emwhbr/caramon/README.md

caramon
=======

Climate monitor for a caravan.

Based on Raspberry Pi2 with sensors for internal temperature,
internal humidity and external temperature. Data logging is done
via cloud and to local disk.
