emwhbr/caramon/doc/temperature_control_2016/temperature_pid_control_2016.odp

## Temperature PID Control

A practical approach using Ziegler-Nichols

Caramon Pi

Håkan Brolin, 2016-01-23

## Closed Loop System

Improved controller, by basing the derivative term on the process value only

PID algorithm

Discrete form

## Ziegler-Nichols


Closed-loop tuning method

Ulitmate gain, Ku=360

Ultimate period, Pu=35 minutes = 2100 sec

Sample time, Ts = 10 minutes = 600 sec

| Kp | Ti | Td
P | Ku / 2 | - | -
PI | Ku / 2.2 | Pu / 1.2 | -
PID | Ku / 1.7 | Pu / 2 | Pu / 8

## Controller Parameters

Ku | 360
Pu [s] | 2100
Ts [s] | 600

| Kp | Ti [s] | Td [s]
P | 180.00 | - | -
PI | 163.64 | 1750 | -
PID | 211.76 | 1050 | 262.50

Z-N

Ki = (Kp x Ts) / Ti

Kd = (Kp x Td) / Ts

| Kp | Ki | Kd | Comment
PID-5 | 163.64 | 56.10 | - | Z-N, PI
PID-6 | 211.76 | 121.01 | 92.65 | Z-N, PID
PID-7 | 163.64 | 42.10 | - | PID-5, Ki decreased 25%
PID-8 | 163.64 | 28.05 | - | PID-5, Ki decreased 50%

## Comparison, Step-up

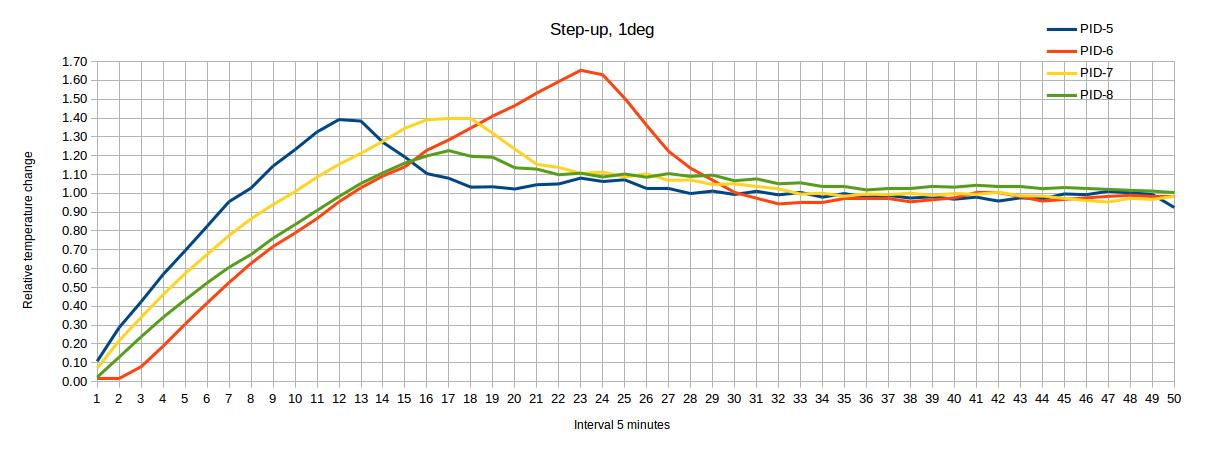
[picture p2: figure]

## Comparison, Step-down

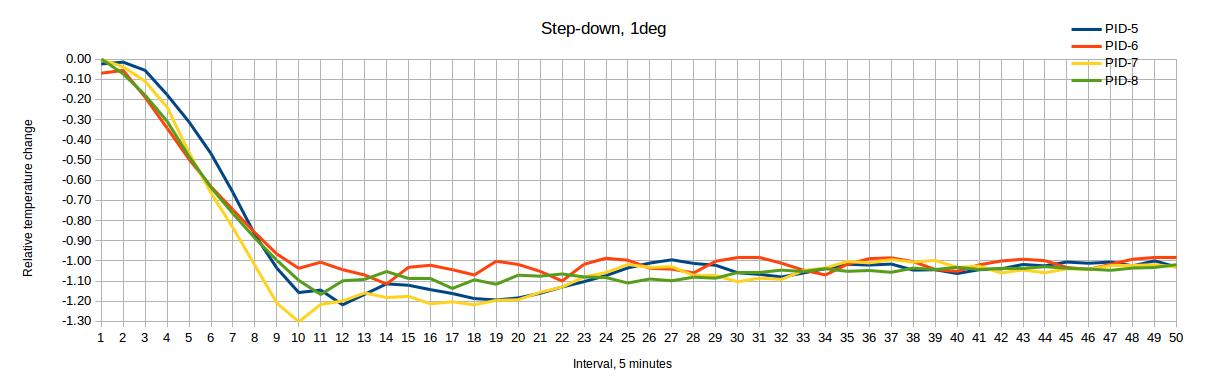
[picture p3: figure]

## Slide 7

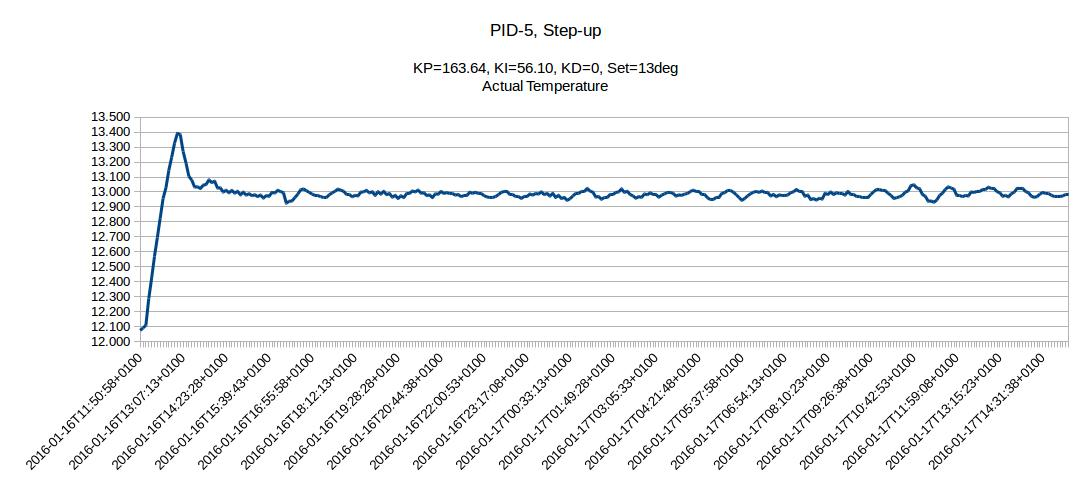
[picture p4: figure]

## Slide 8

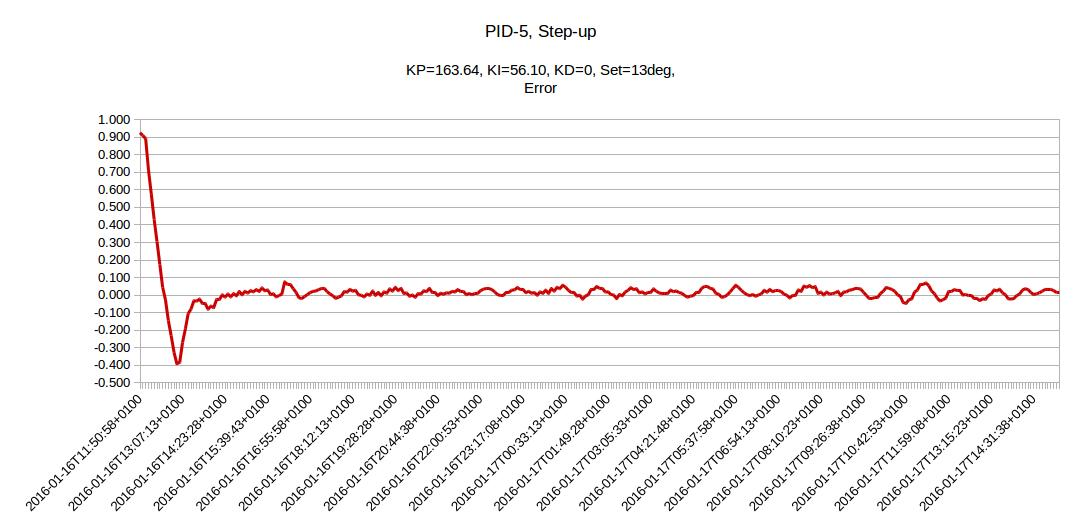
[picture p5: figure]

## Slide 9

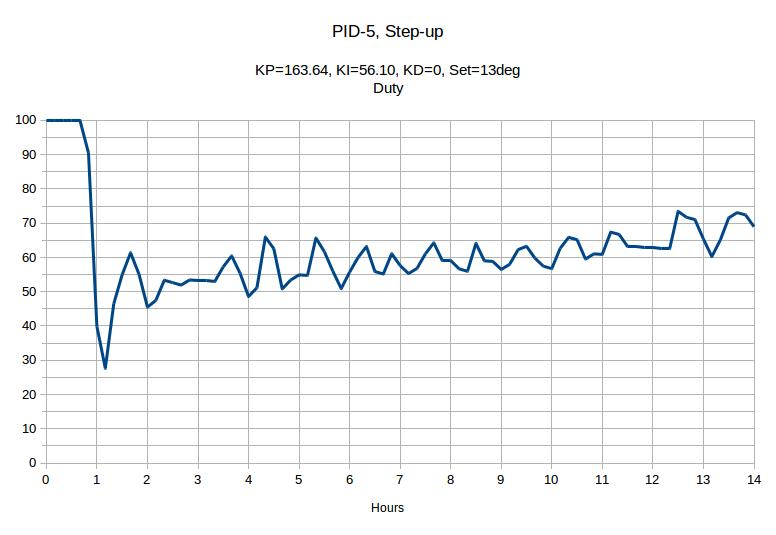
[picture p6: figure]

## Slide 10

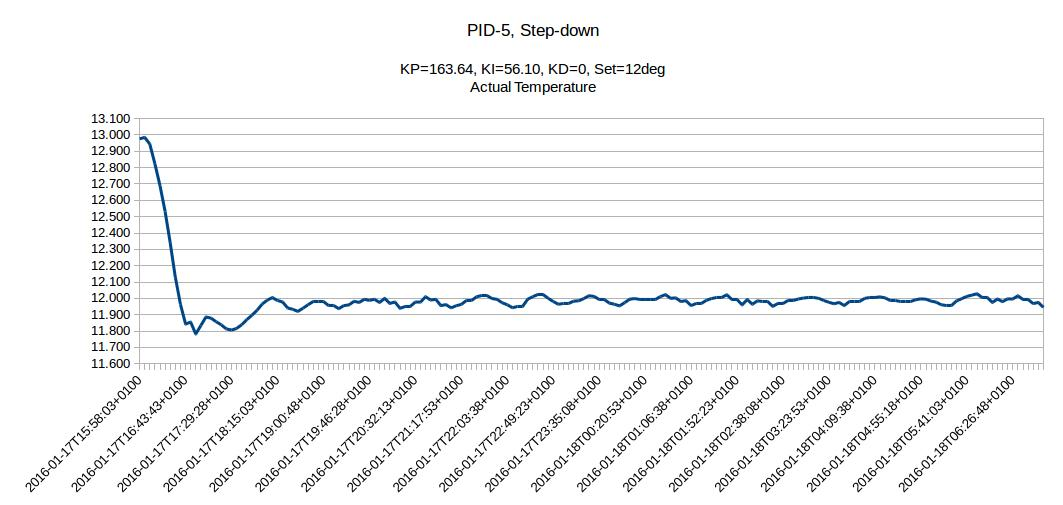
[picture p7: figure]

## Slide 11

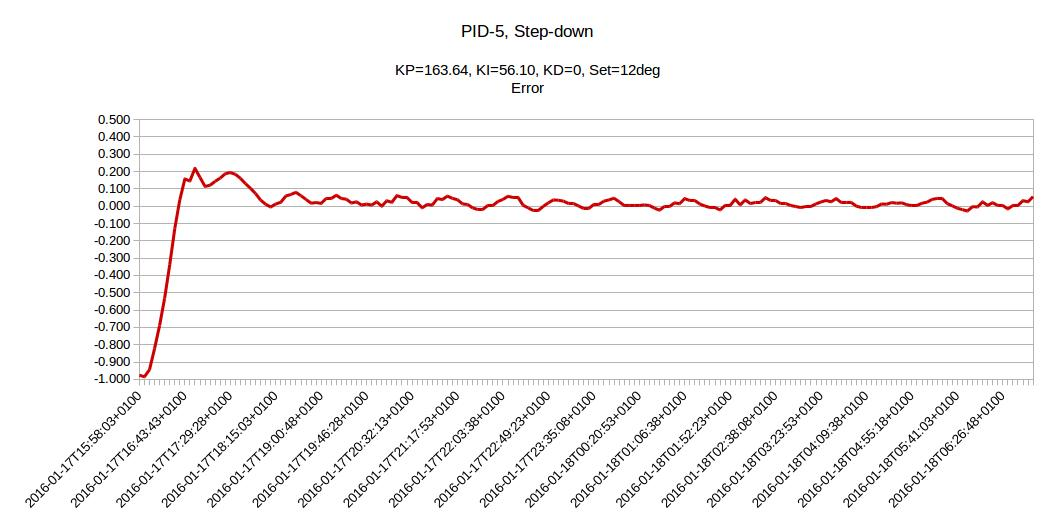
[picture p8: figure]

## Slide 12

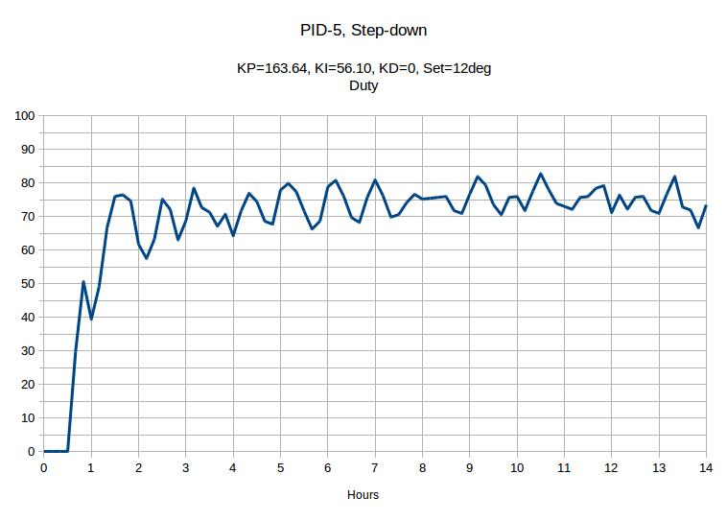
[picture p9: figure]

## Slide 13

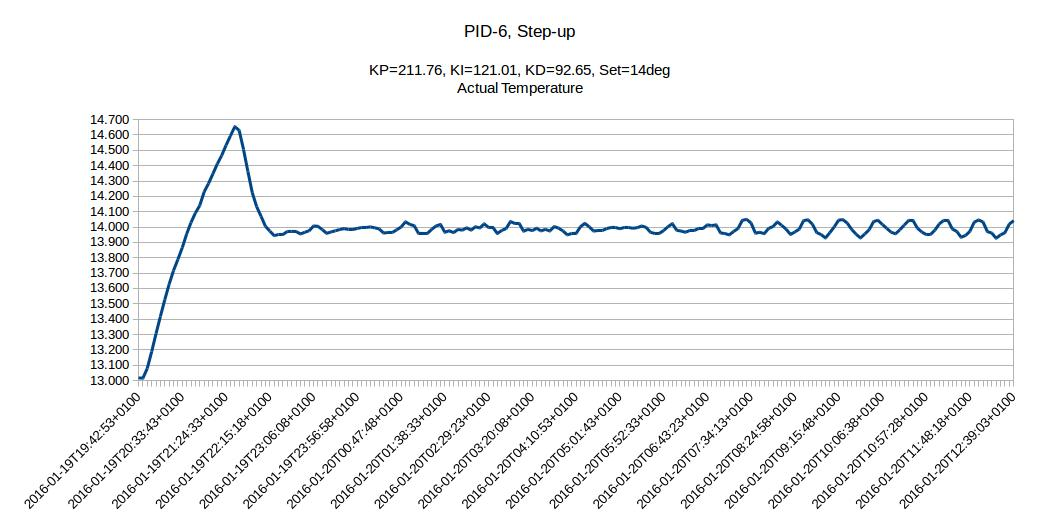
[picture p10: figure]

## Slide 14

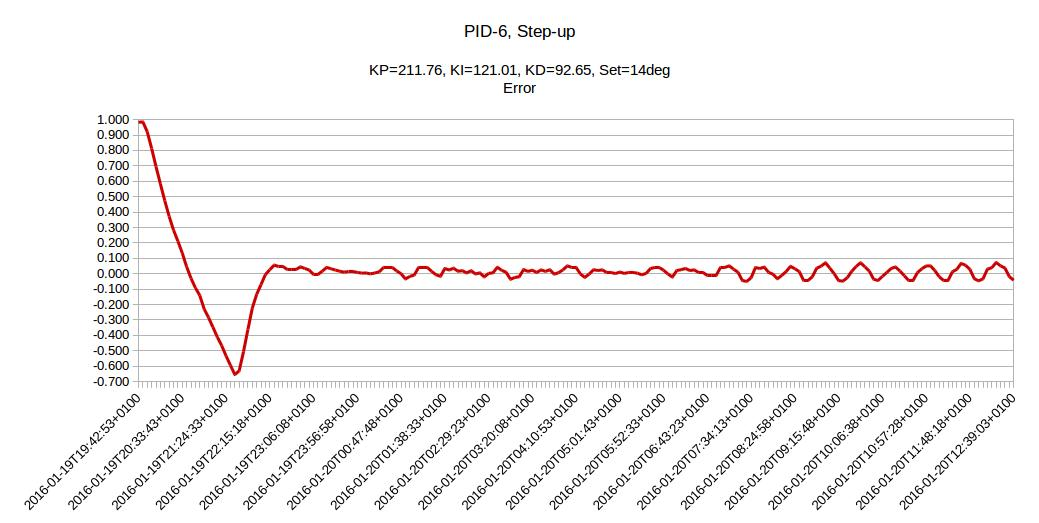
[picture p11: figure]

## Slide 15

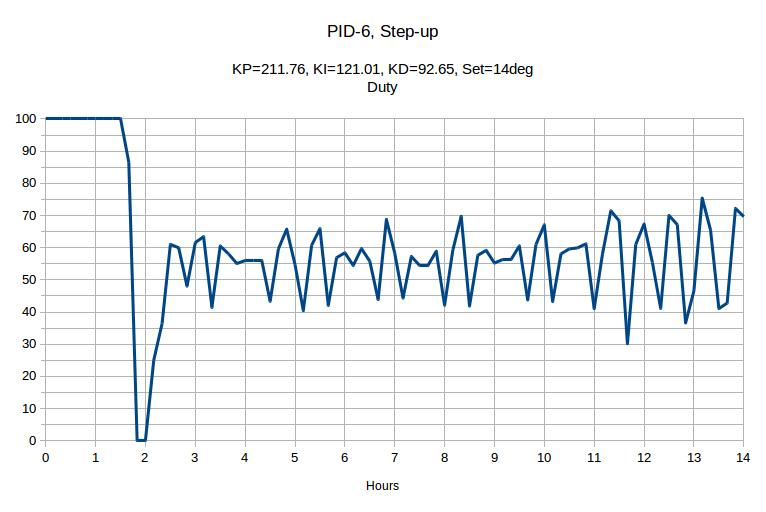
[picture p12: figure]

## Slide 16

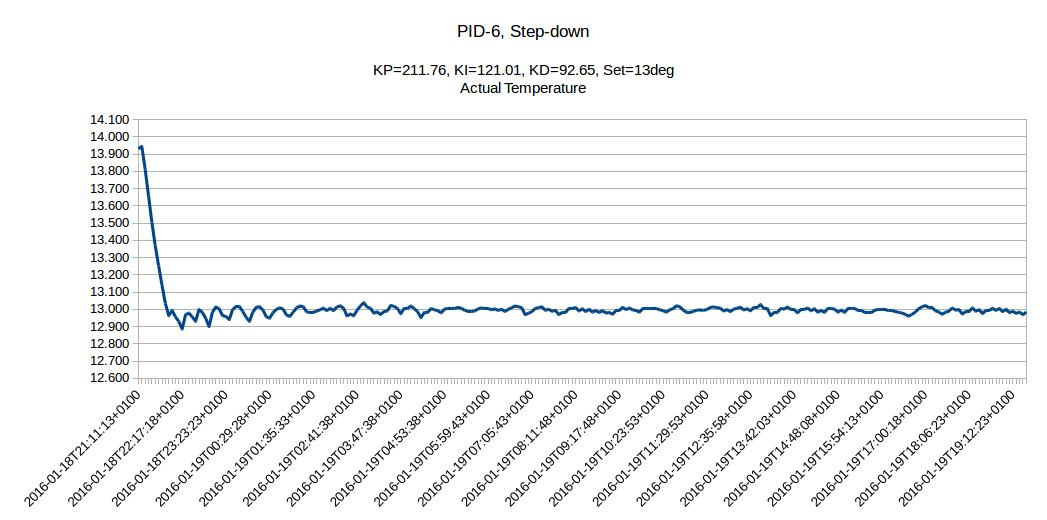
[picture p13: figure]

## Slide 17

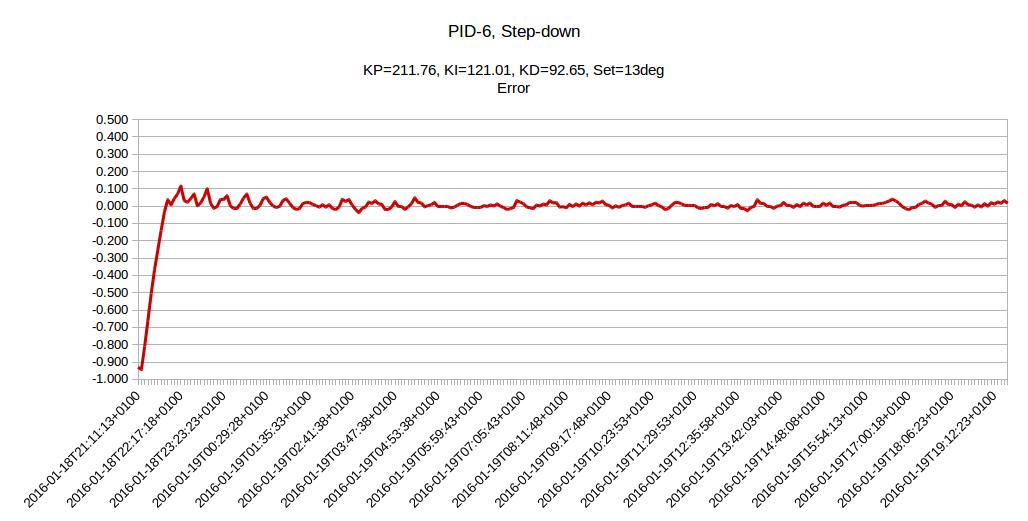
[picture p14: figure]

## Slide 18

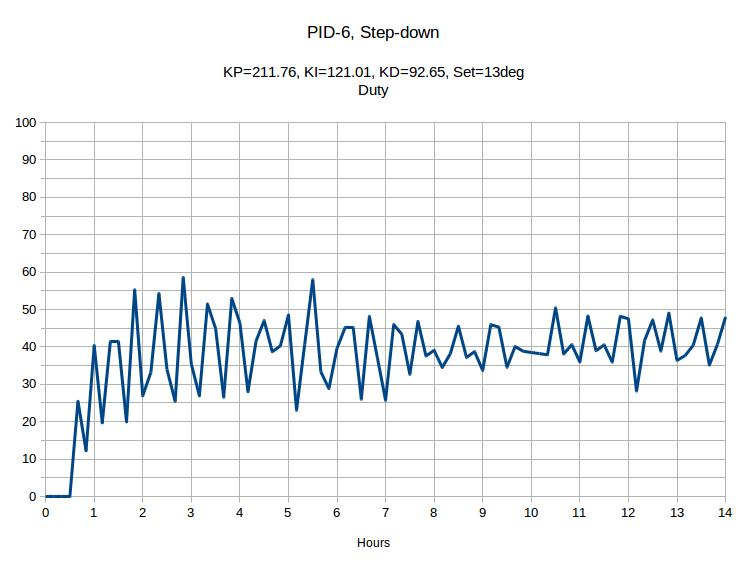
[picture p15: figure]

## Slide 19

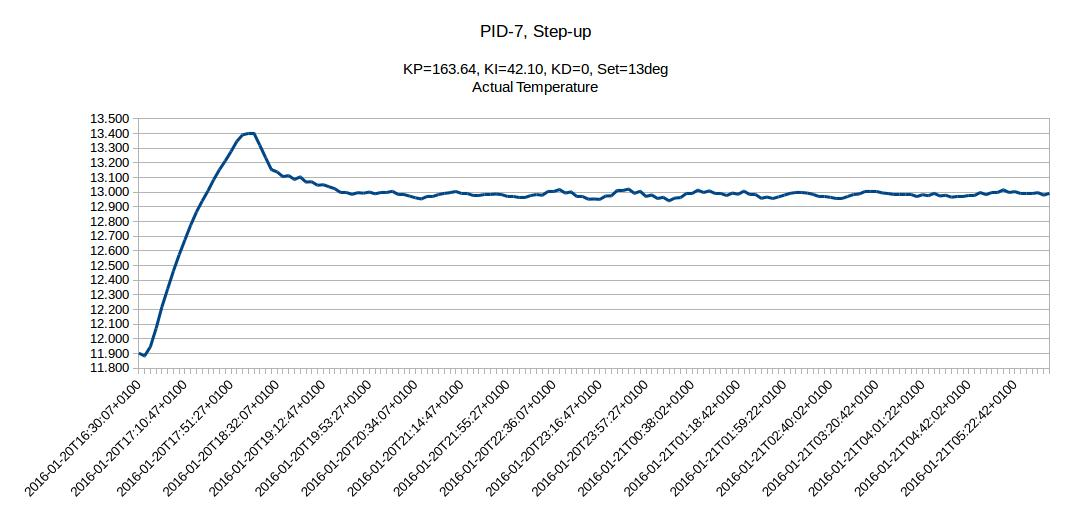
[picture p16: figure]

## Slide 20

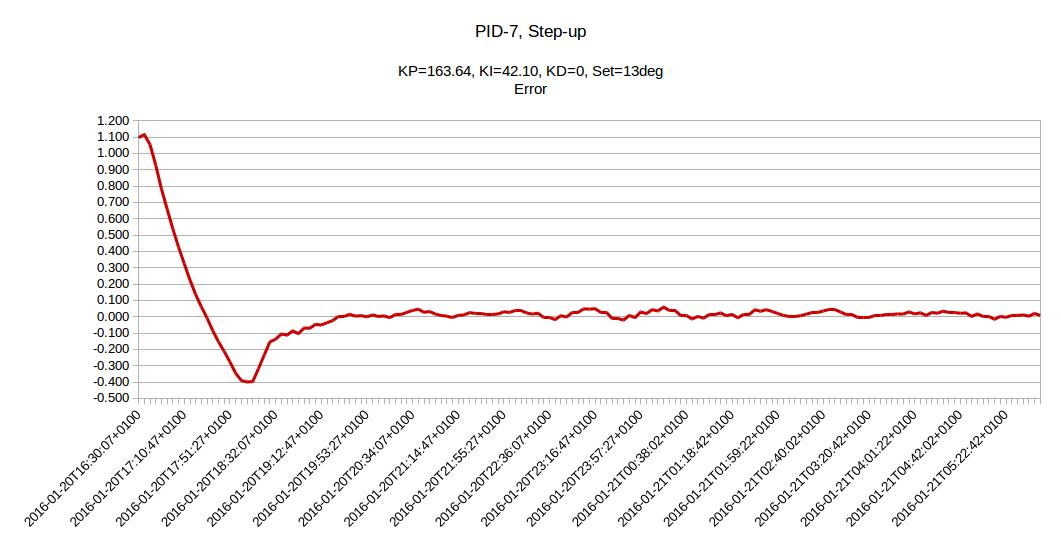
[picture p17: figure]

## Slide 21

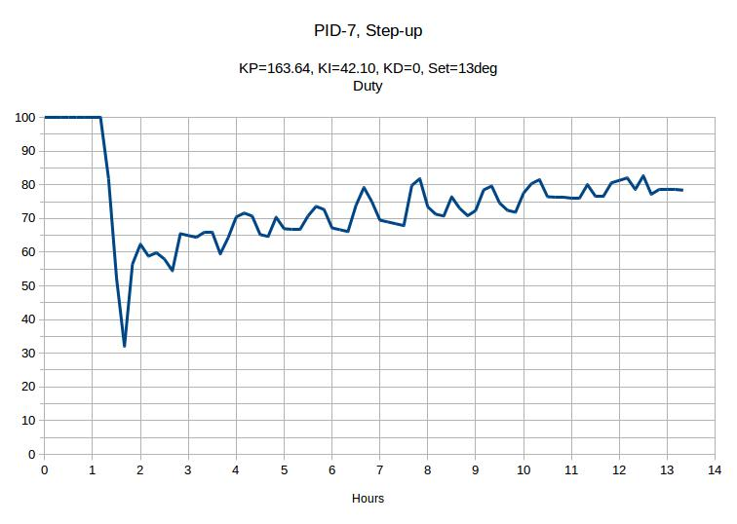
[picture p18: figure]

## Slide 22

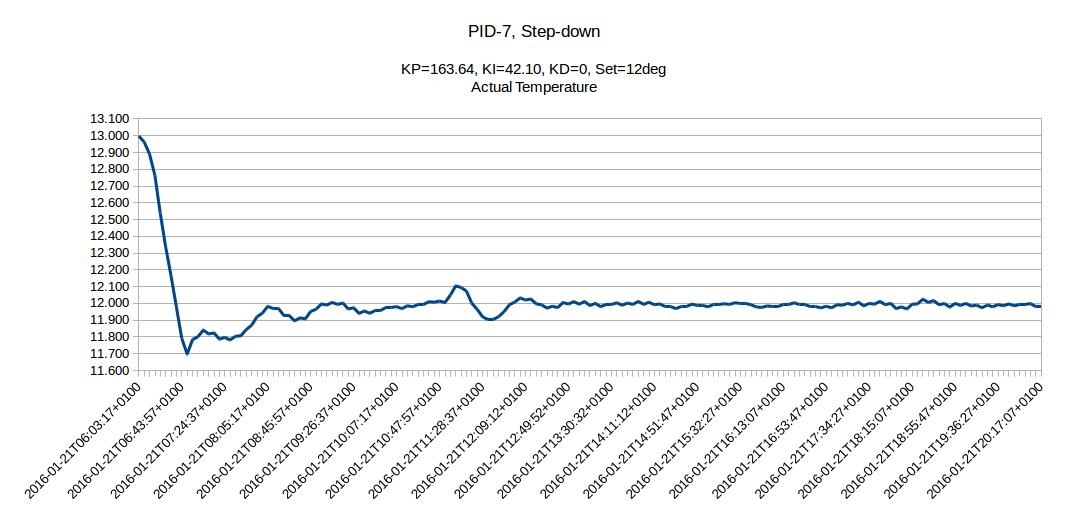
[picture p19: figure]

## Slide 23

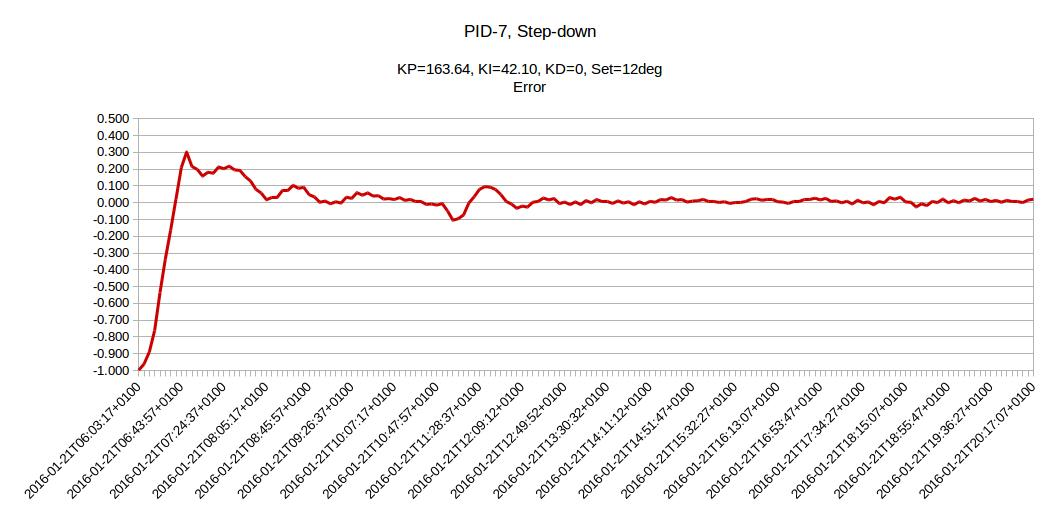
[picture p20: figure]

## Slide 24

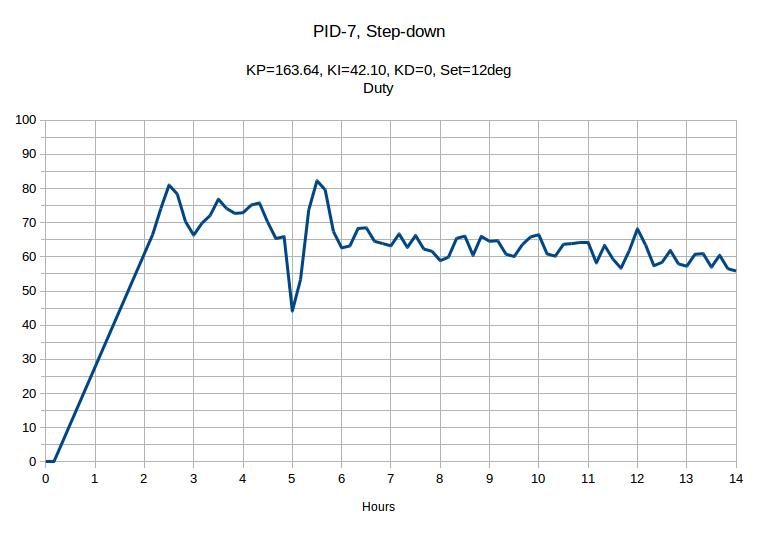
[picture p21: figure]

## Slide 25

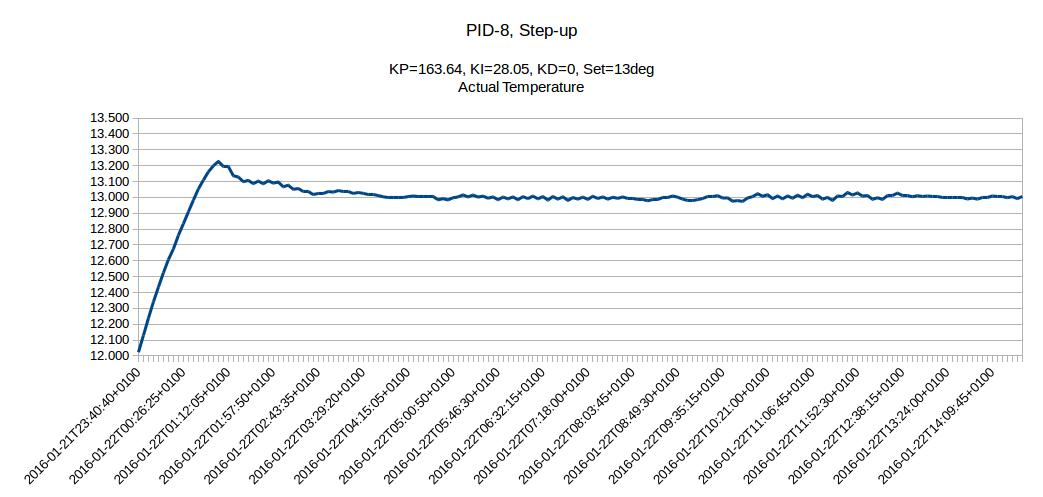
[picture p22: figure]

## Slide 26

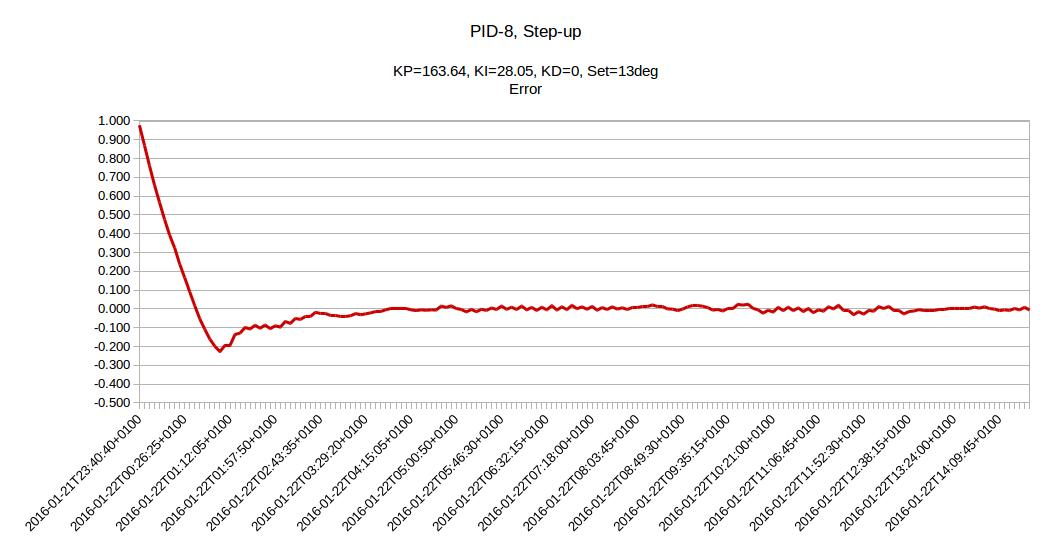
[picture p23: figure]

## Slide 27

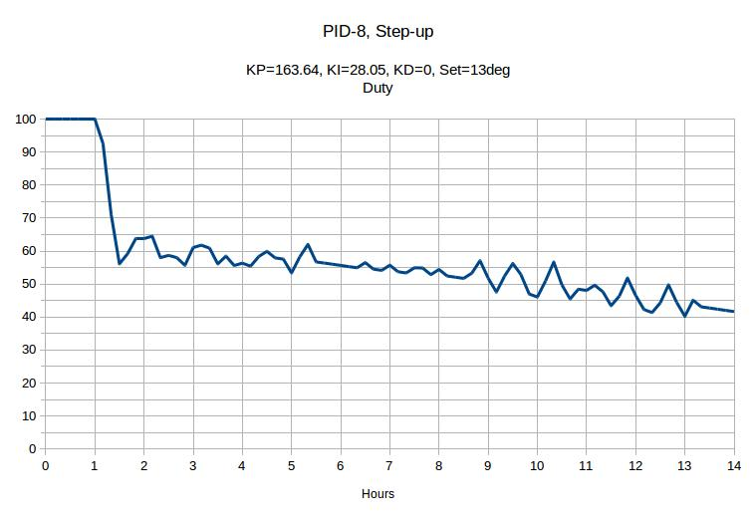
[picture p24: figure]

## Slide 28

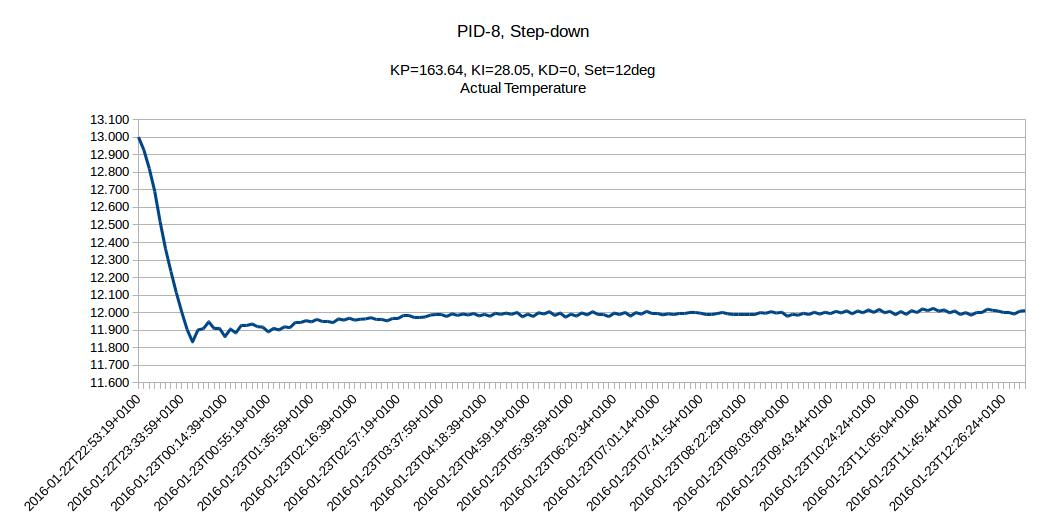
[picture p25: figure]

## Slide 29

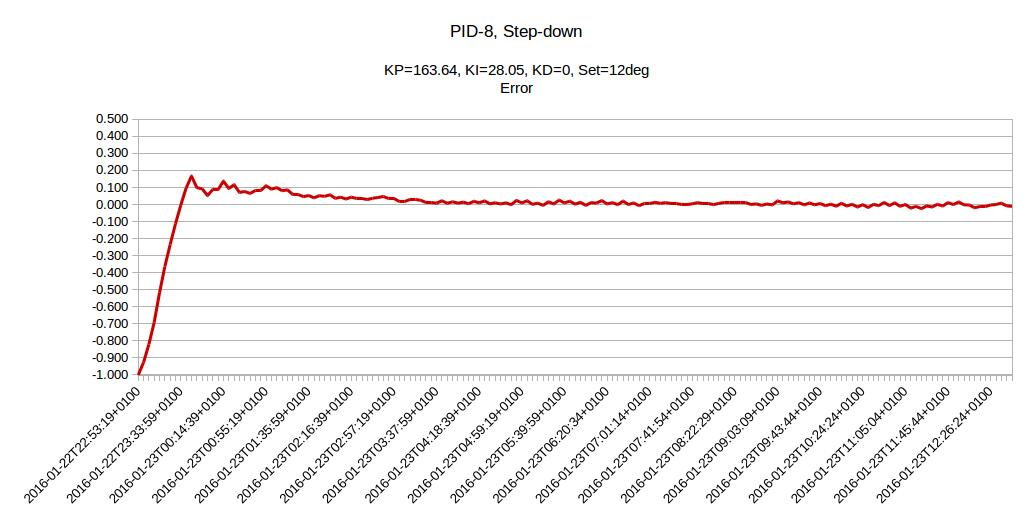
[picture p26: figure]

## Slide 30

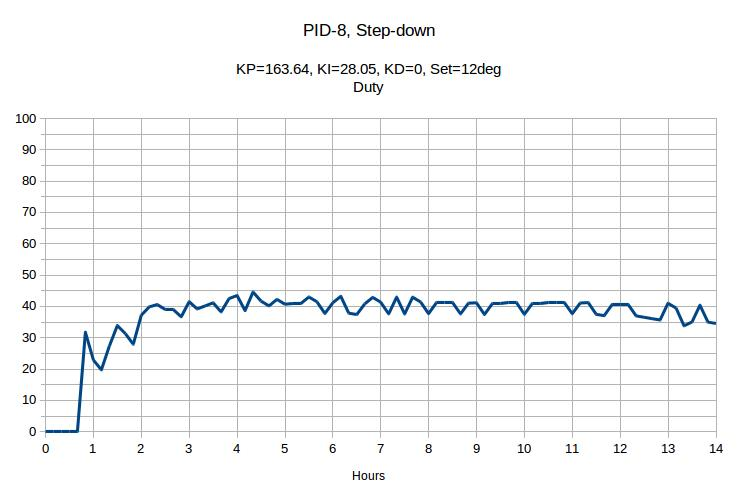
[picture p27: figure]
