emwhbr/caramon/doc/caramon_description.pdf

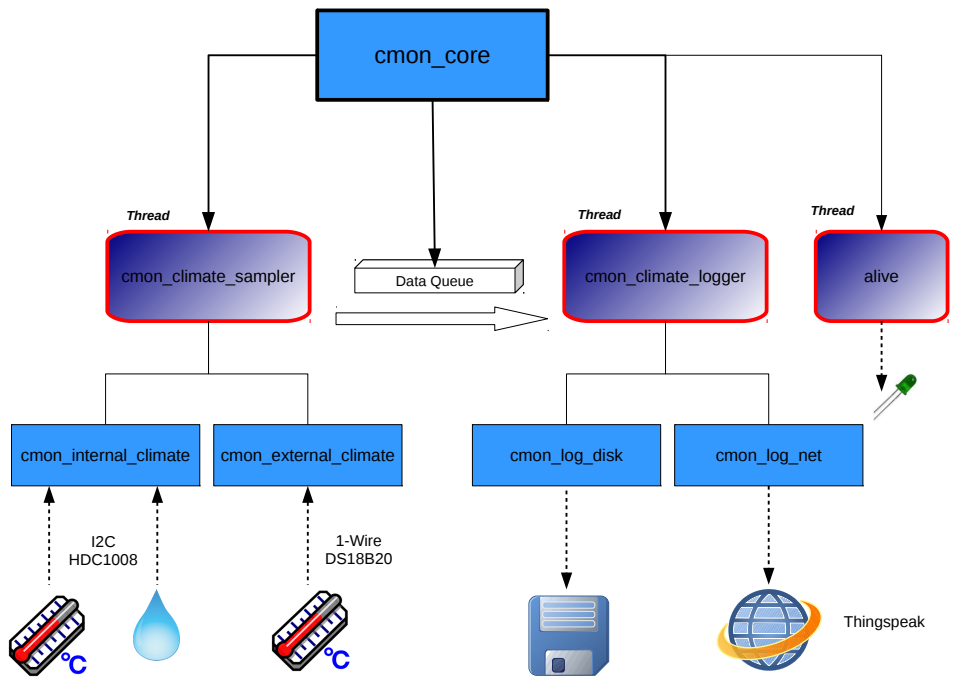
[picture p28: page 1]
cmon_core; cmon_climate_logger; Thread; cmon_climate_sampler; cmon_internal_climate; cmon_external_climate; cmon_log_disk; cmon_log_net; Data Queue; I2C HDC1008; 1-Wire DS18B20; Thingspeak; alive

glost_core

- m_mode
- m_local_ip
- m_verbose
- virtual initialize()
- virtual finalize()
- virtual check_ok()

cmon_log

- m_name
- m_verbose
- virtual initialize() = 0
- virtual finalize() = 0
- virtual log_climate_data = 0
- get_date_time_str()

cmon_log_disk

- m_climate_data_file
- initialize()
- finalize()
- log_climate_data()

cmon_log_net

- m_sc
- initialize()
- finalize()
- log_climate_data()

Channel info:

- Channel name: caramonpi
- | Channel id: | 75139
- | Address: | https://thingspeak.com/channels/75139/
- Write API Key: xxxxxxxx
- Read API Key: yyyyyyyy
- Field 1: Internal Temperature
- Field 2: Internal Humidity
- Field 3: External Temperature

## Thingspeak

Update channel:

curl fail silent data \

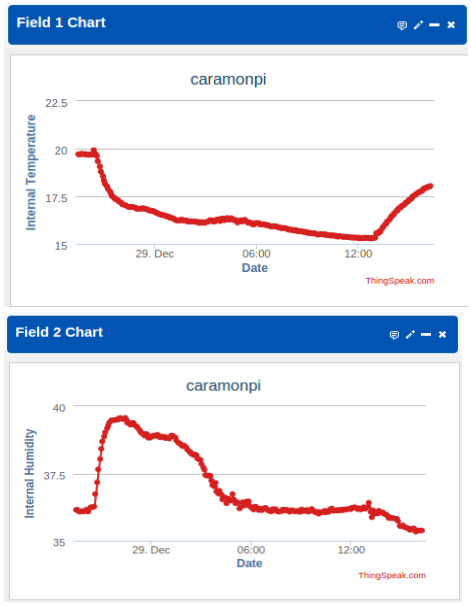
[picture p29: figure]

"key=<WRITEKEY>&field1=<VAL1>&field2=<VAL2>&field3=<VAL3>" https://api.thingspeak.com/update

Check return code: echo $?

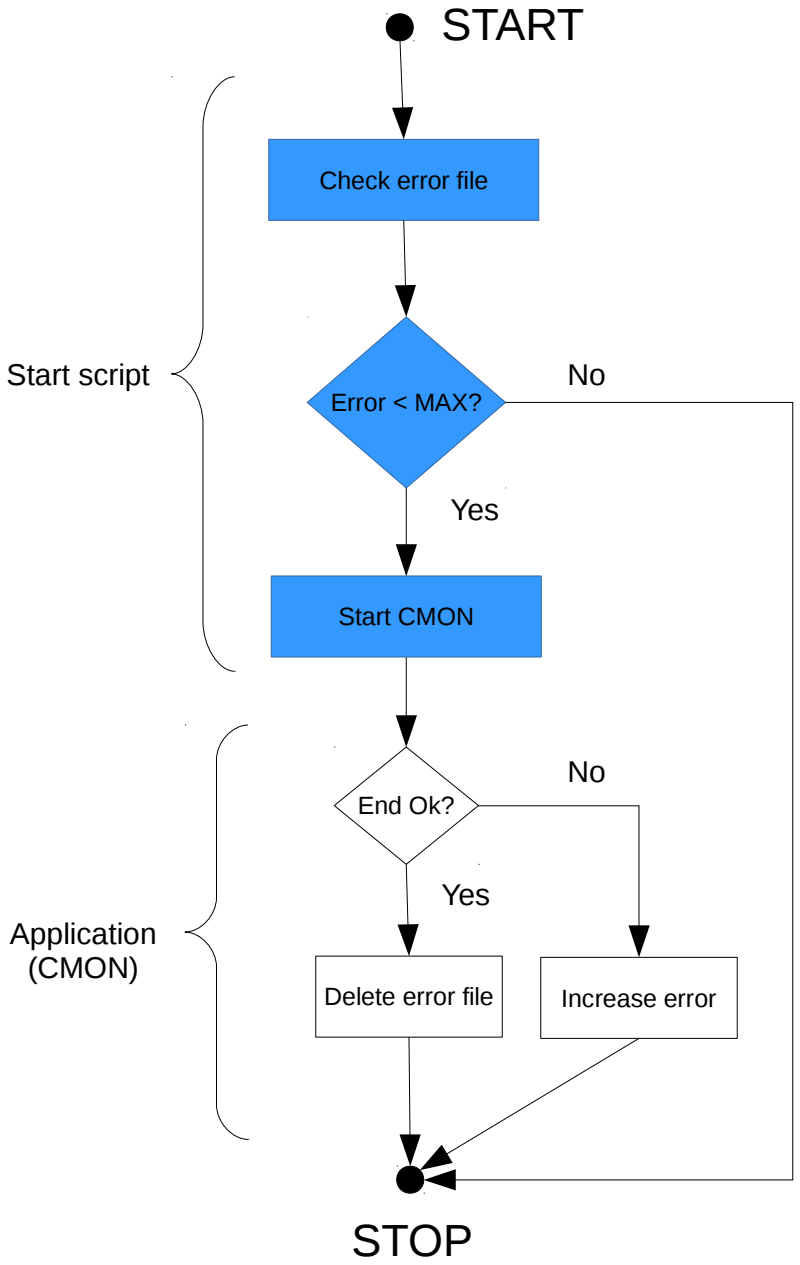
[picture p30: figure]
Error < MAX?; Start CMON; End Ok?; Delete error file; Increase error; Check error file; STOP; START; Yes; Start script; Application (CMON)
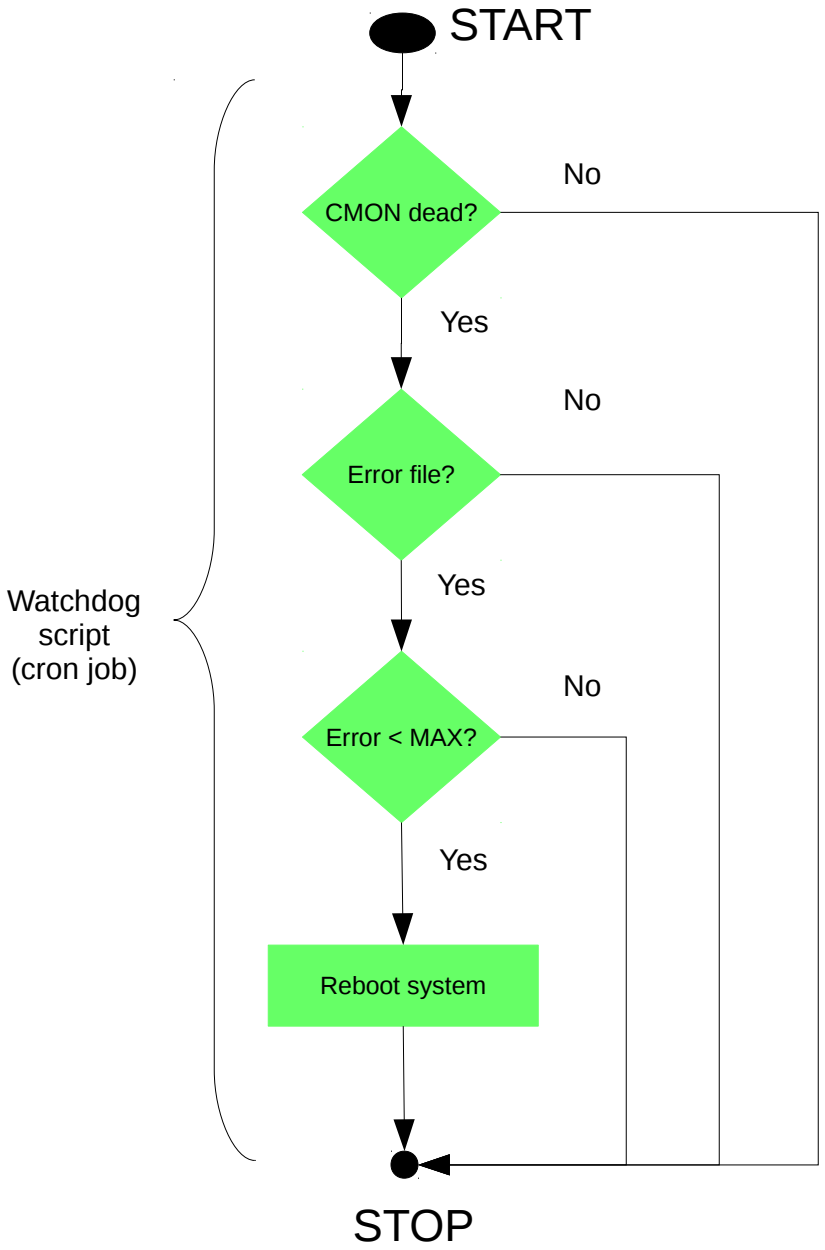
[picture p31: figure]
Yes; START; Error file?; STOP; Error < MAX?; Reboot system; Watchdog script (cron job); CMON dead?

crontab l

@reboot /usr/bin/weavedstart.sh
*/5 * * * * /caramon/cmon_watchdog.sh

crontab e

#*/5 * * * * /caramon/cmon_watchdog.sh

/etc/init.d/cron restart
/etc/init.d/cron status

Script executed every 5 minutes

List active cron jobs

Disable cron job

Commented out, script disabled

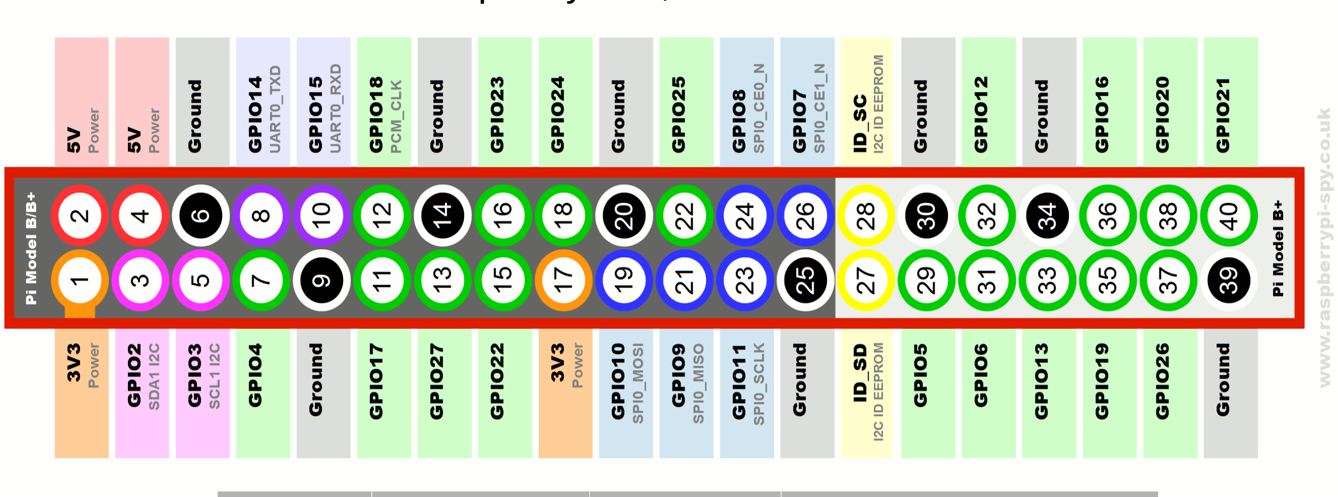
[picture p32: figure]

Raspberry Pi2 , Connector P1

CMON,
GPIO
Pin (P1) | GPIO (BCM) | Direction | Description
03 | 2 | - | I2C - SDA
05 | 3 | - | I2C - SCL
08 | 14 | - | RS232 - Tx
10 | 15 | - | RS232 - Rx
11 | 17 | OUT | LED (green) - Alive
12 | 18 | OUT | LED (red) - Sysfail
13 | 27 | IN | Normal (0), Inhibit (1)
15 | 22 | OUT | Radiator control, SSR K1
16 | 23 | OUT | WDI - Watchdog keep alive
18 | 24 | OUT | WDE - Watchdog enable
22 | 25 | IN | 1-Wire

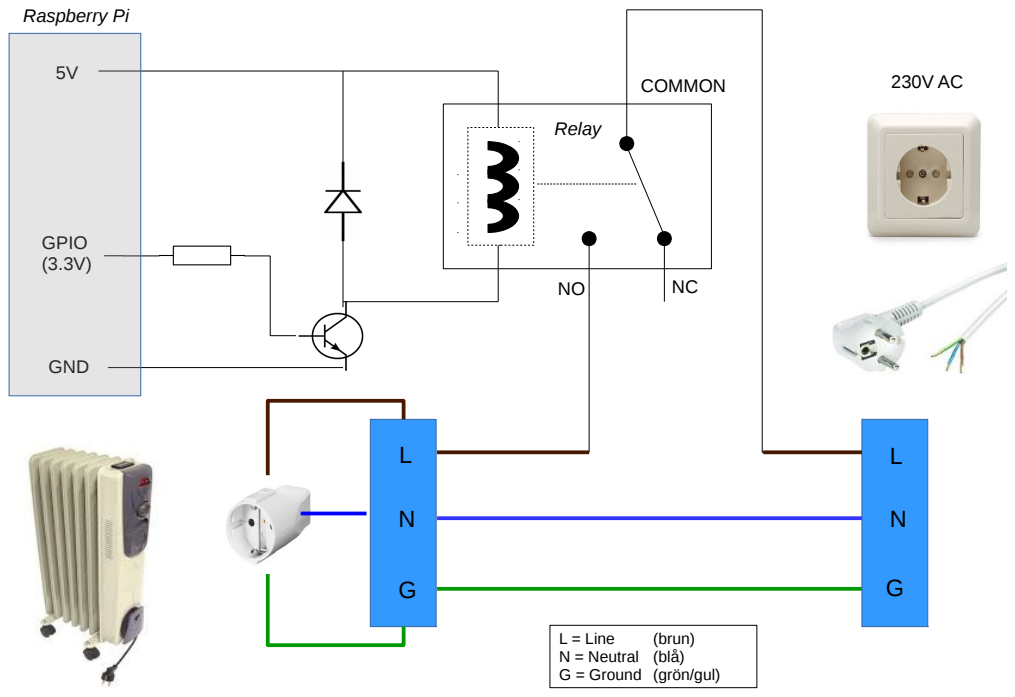
[picture p33: page 7]
L = Line; (brun); COMMON; GND; GPIO (3.3V); Relay; Raspberry Pi

N = Neutral (blå)
G = Ground (grön/gul)

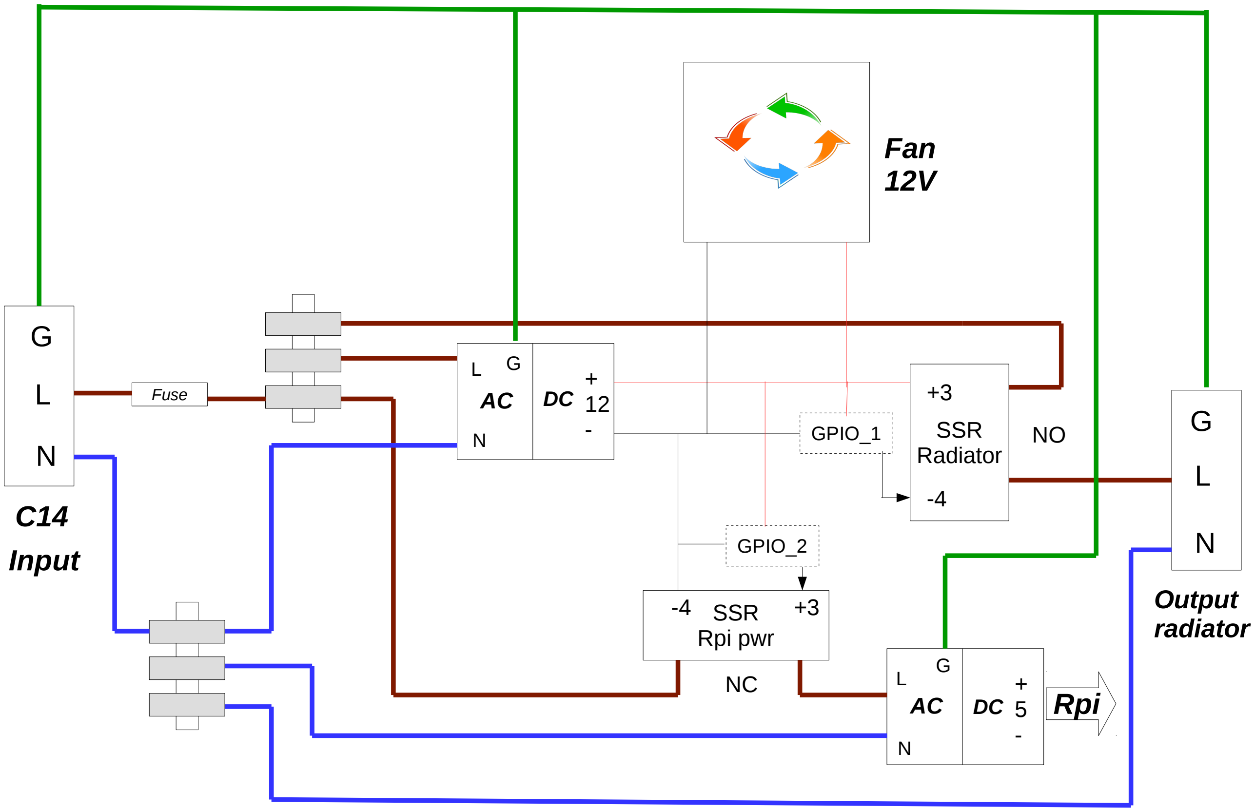
[picture p34: figure]
SSR Radiator; SSR Rpi pwr; Fuse; GPIO_1; GPIO_2; Fan 12V; Rpi; Input; Output radiator

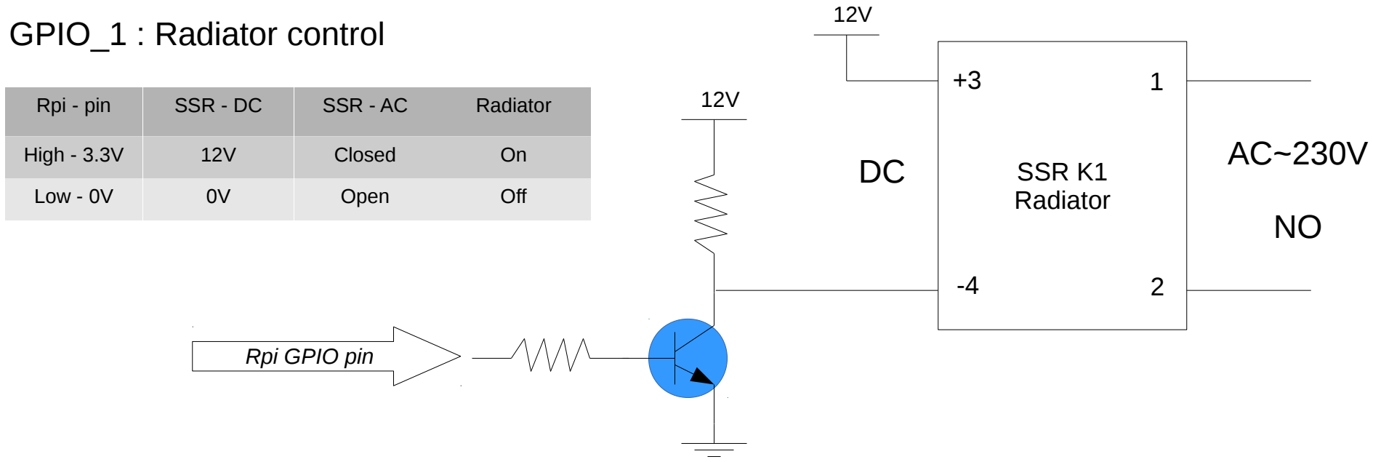
[picture p35: figure]
SSR K1 Radiator; GPIO_1 : Radiator control; Rpi GPIO pin; Rpi - pin; SSR - DC; SSR - AC; Radiator; High - 3.3V; Closed; Low - 0V; Open; Off
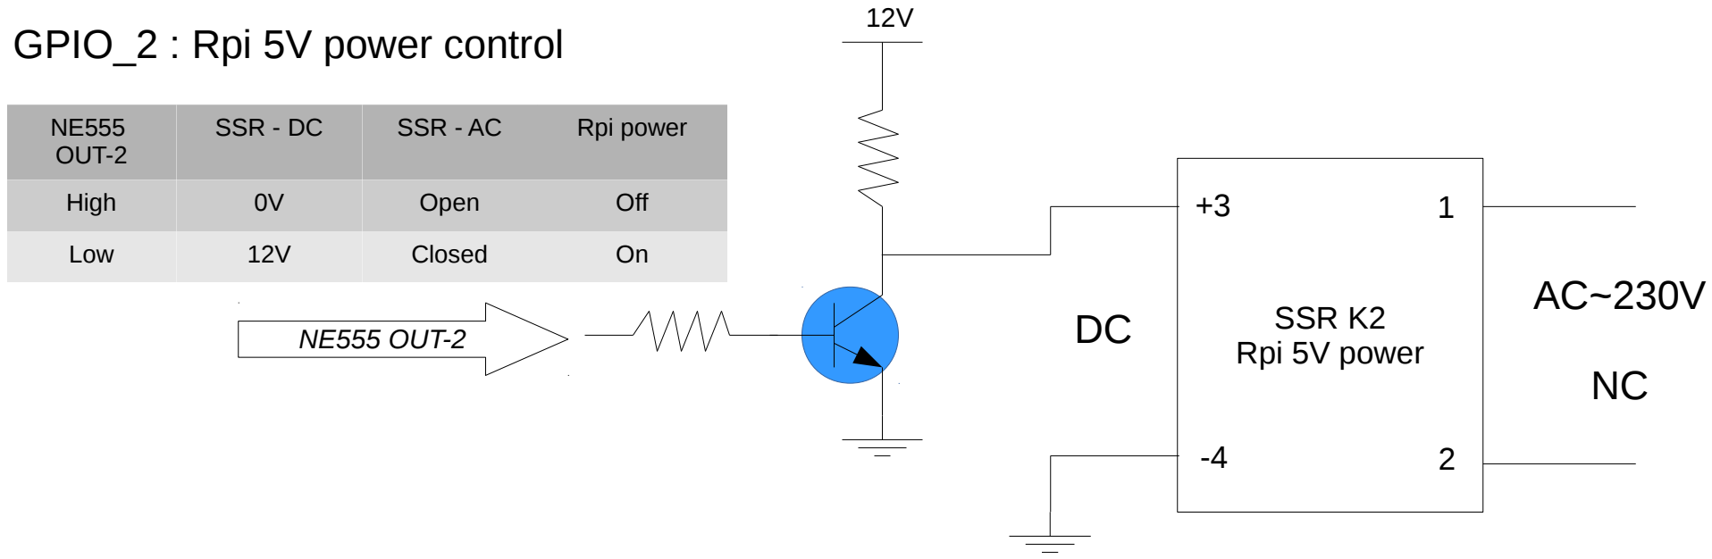
[picture p36: figure]
GPIO_2 : Rpi 5V power control; SSR K2 Rpi 5V power; NE555 OUT-2; SSR - DC; SSR - AC; Rpi power; High; Open; Off; Low; Closed
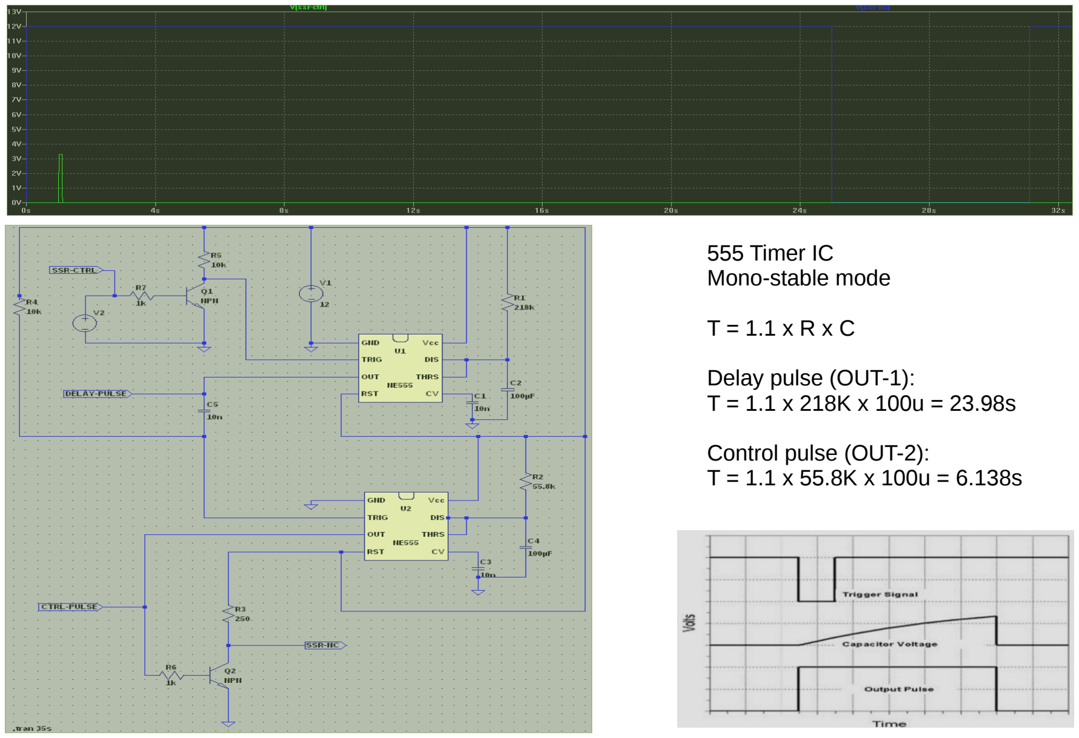
[picture p37: page 10]

555 Timer IC
Mono-stable mode

T = 1.1 x R x C

Delay pulse (OUT-1):
T = 1.1 x 218K x 100u = 23.98s

Control pulse (OUT-2):
T = 1.1 x 55.8K x 100u = 6.138s
