emwhbr/caramon/wdt_test/README

Simple test application for the hardware watchdog timer (WDT) circuit.
