emwhbr/caramon/kicad/cmon_hw_iface/cmon_hw_iface.pdf

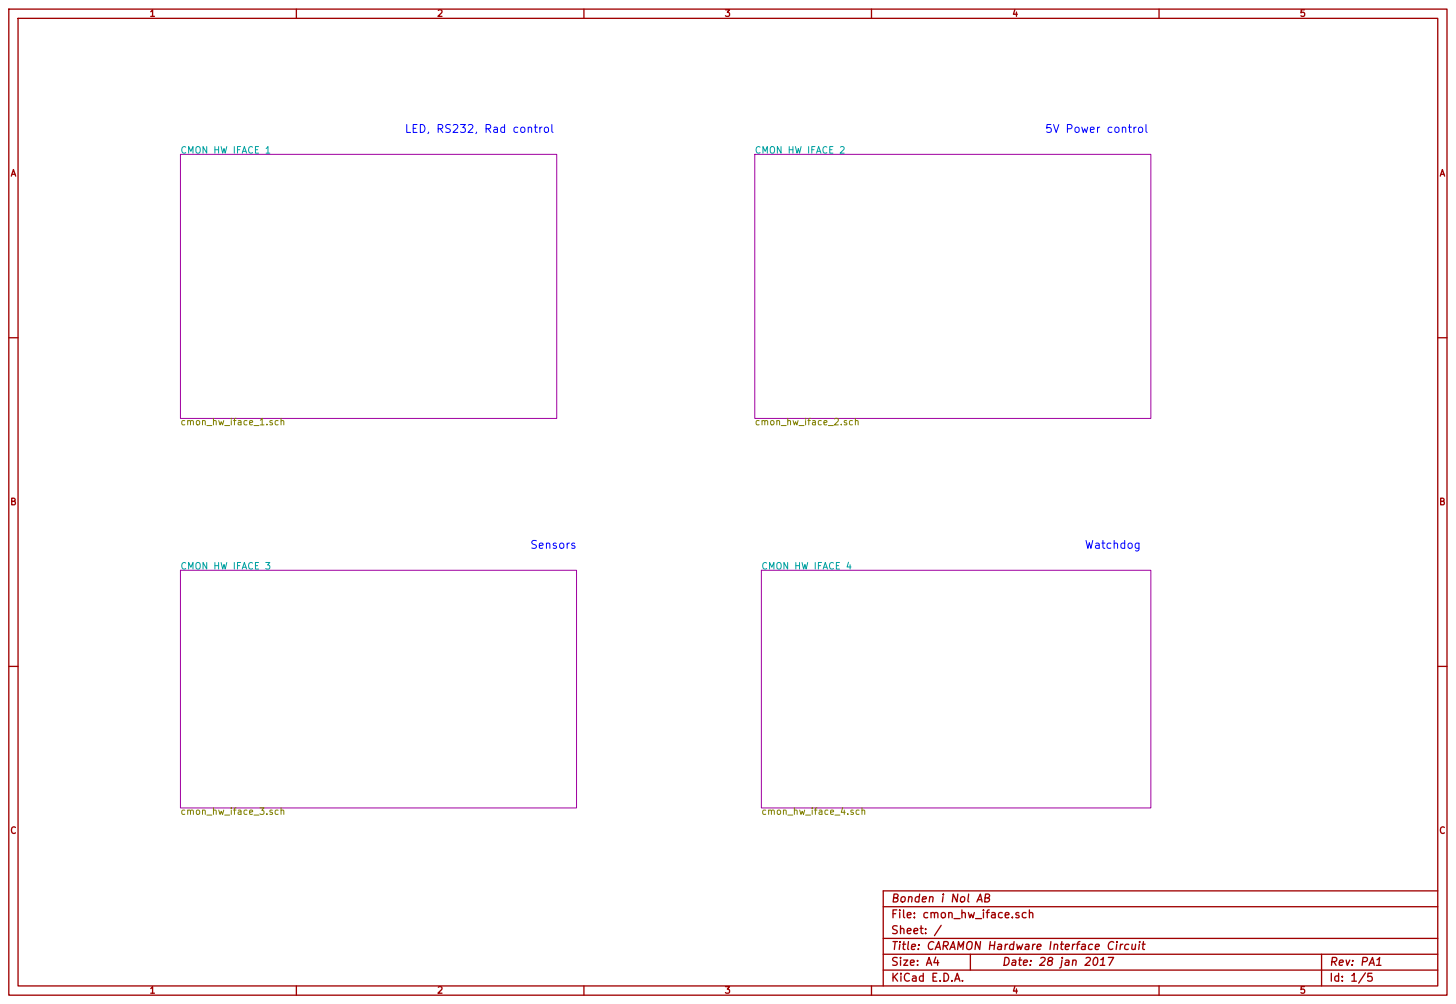
[picture p38: page 1]

cmon_hw_iface_2.sch CMON HW IFACE 3

Sheet: / Bonden i Nol AB
File: cmon_hw_iface.sch

Title: CARAMON Hardware Interface Circuit
KiCad E.D.A.

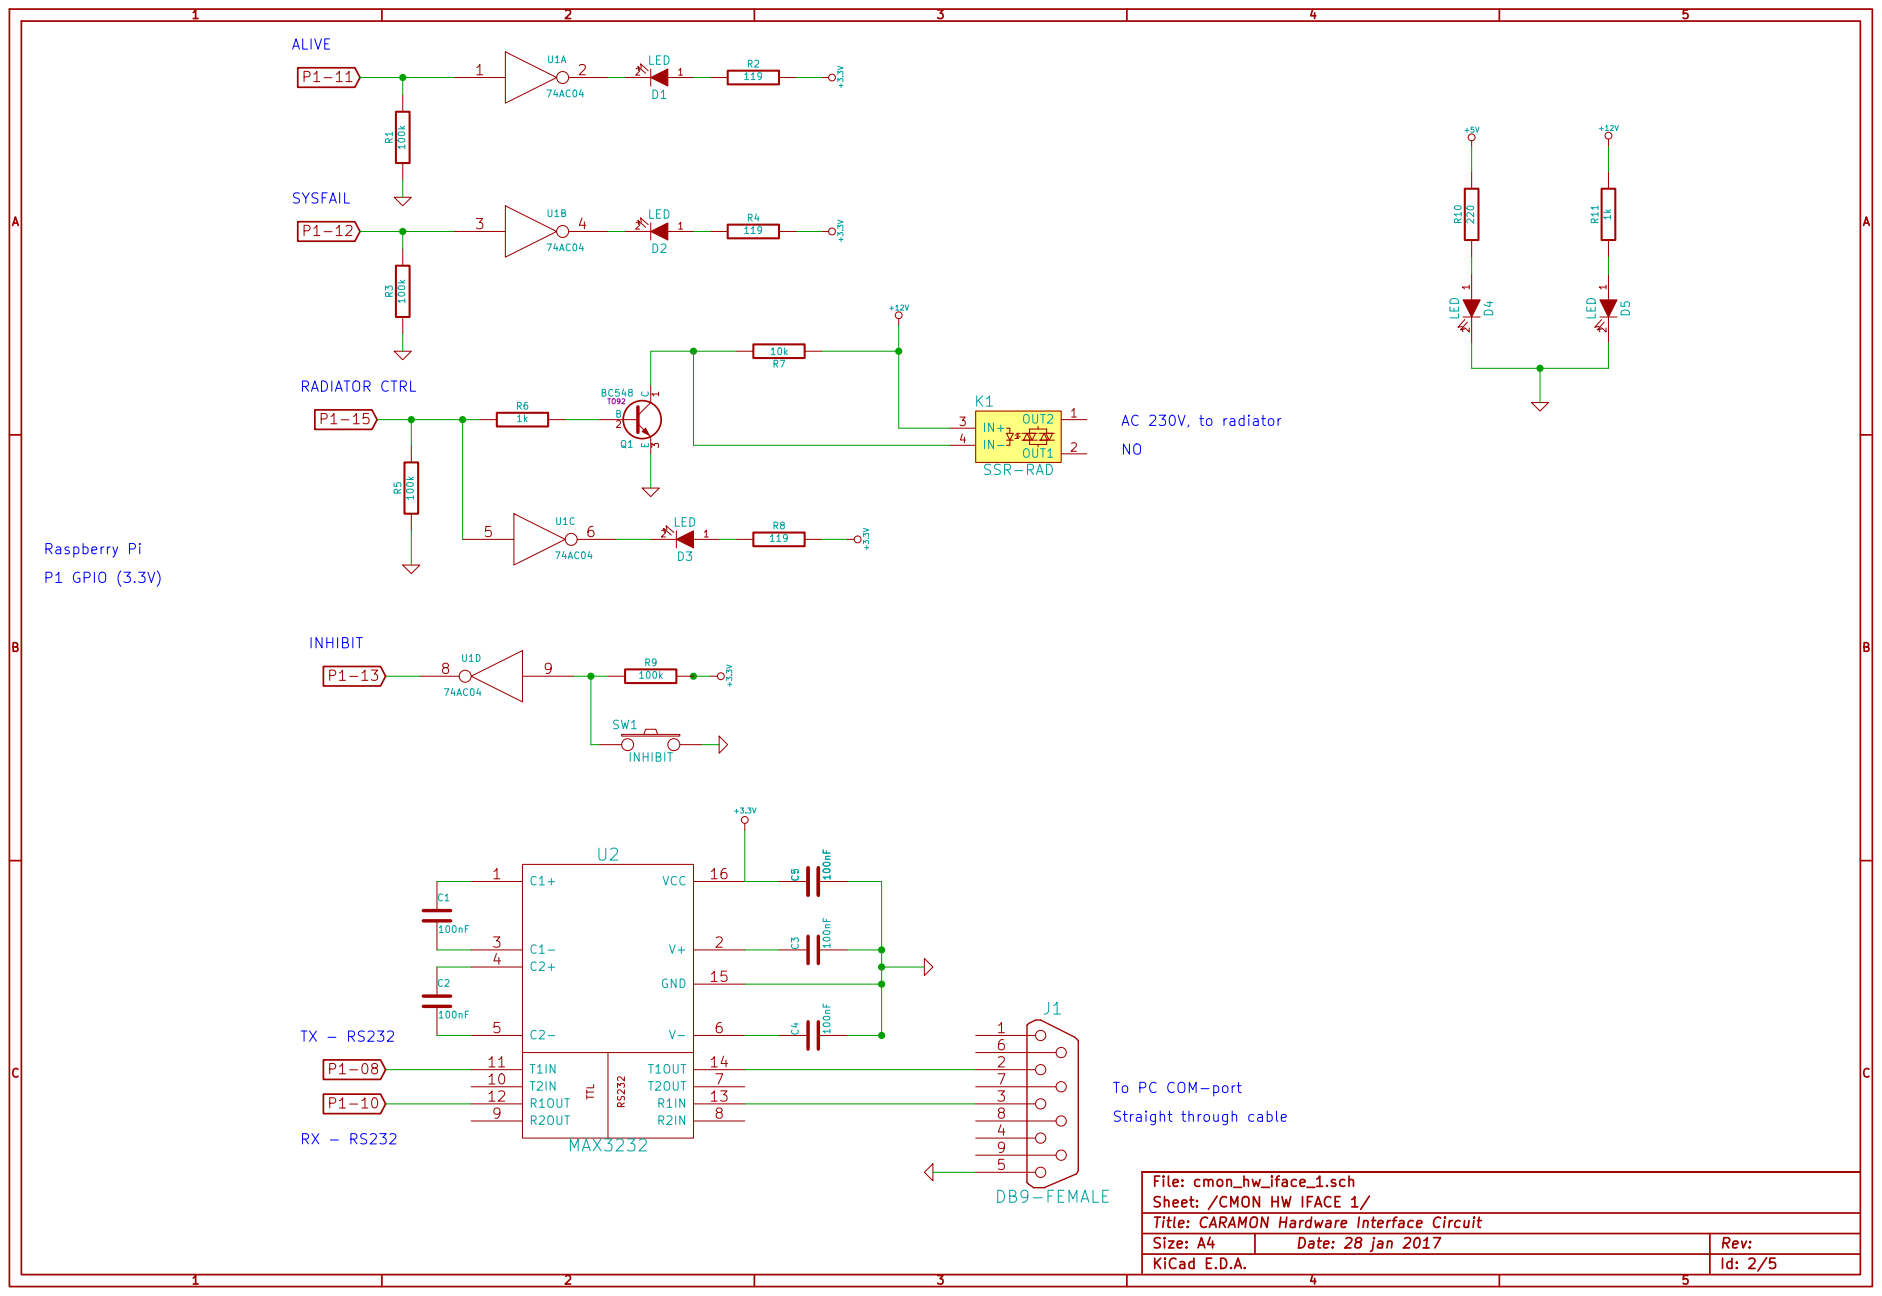
[picture p39: page 2]

Sheet: /CMON HW IFACE 1/ RS232 TTL C1+ 1

Title: CARAMON Hardware Interface Circuit

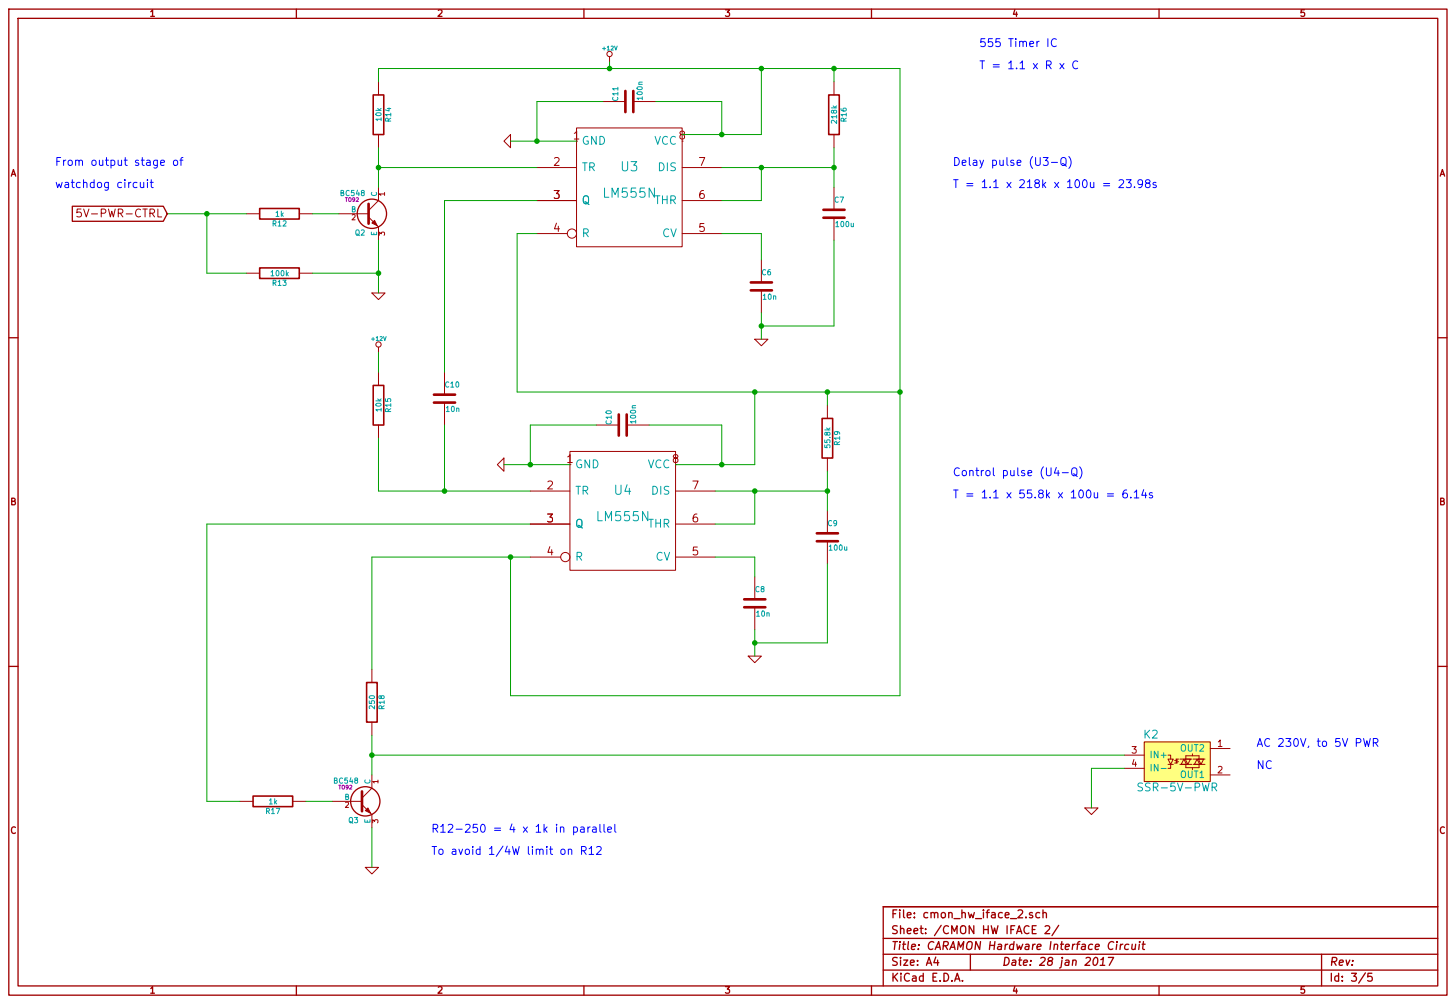
[picture p40: page 3]

From output stage of
watchdog circuit

File: cmon_hw_iface_2.sch
Sheet: /CMON HW IFACE 2/
Title: CARAMON Hardware Interface Circuit

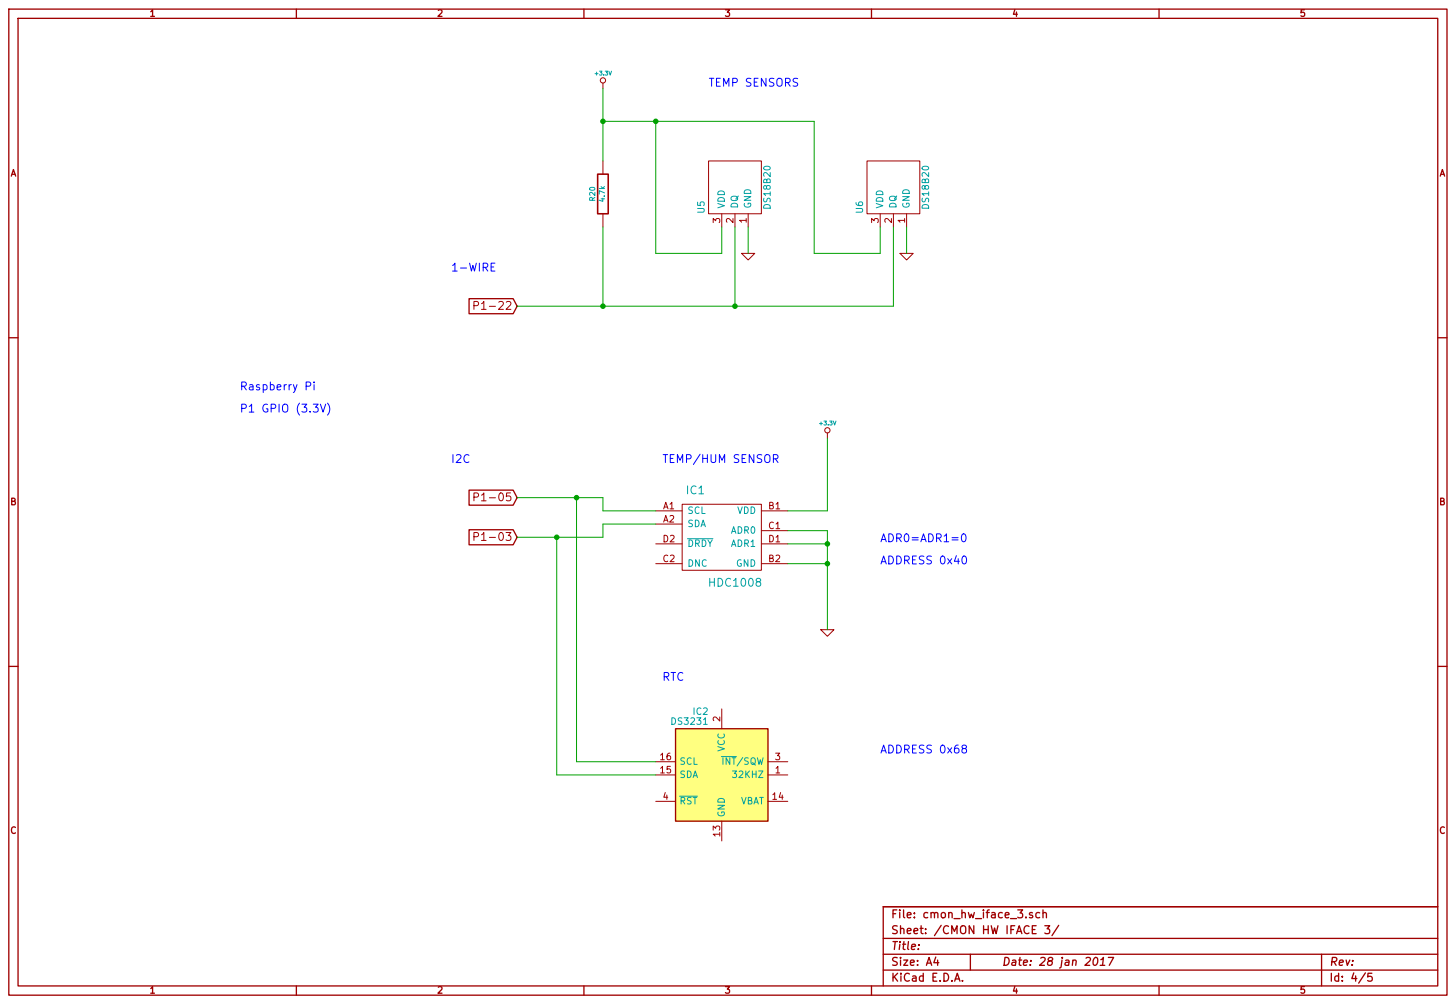
[picture p41: page 4]

Id: 4/5 Title: File: cmon_hw_iface_3.sch
Sheet: /CMON HW IFACE 3/

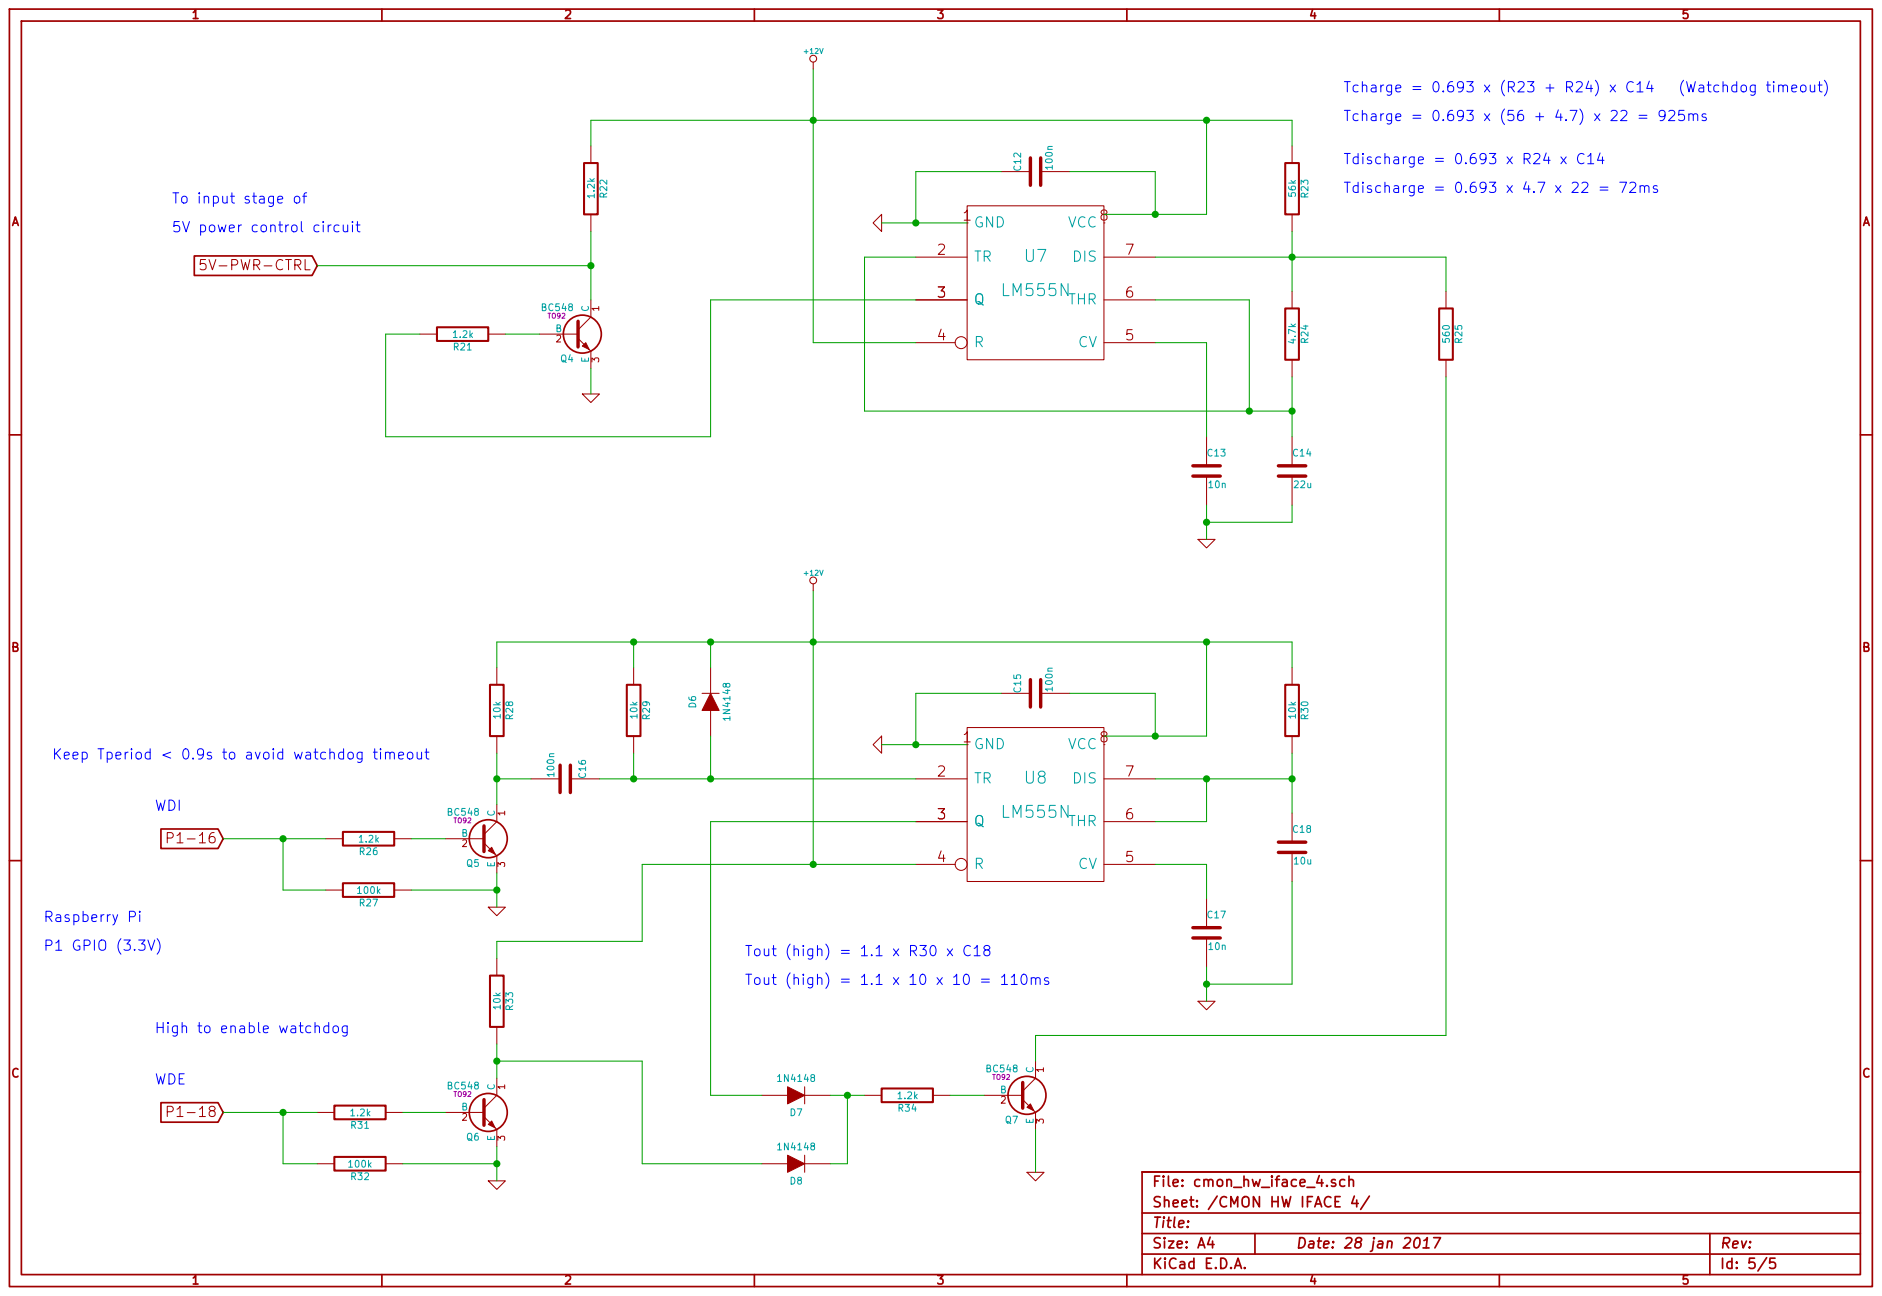
[picture p42: page 5]

To input stage of
5V power control circuit

Keep Tperiod < 0.9s to avoid watchdog timeout

Sheet: /CMON HW IFACE 4/ C

100k High to enable watchdog

Id: 5/5 Title: File: cmon_hw_iface_4.sch
