emwhbr/caramon/ltspice/watchdog_timer/wdt.asc

C1: cap; 10n
C2: cap; 22µF
C3: cap; 10n
C4: cap; 10µF
C5: cap; 0.1µ
D1: diode; 1N4148
D2: diode; 1N4148
D3: diode; 1N4148
Q1: npn
Q2: npn
Q3: npn
Q4: npn
Q5: npn
R1: res; 56k
R2: res; 4.7k
R3: res; 560
R4: res; 10k
R5: res; 10k
R6: res; 1k
R7: res; 1k
R8: res; 10k
R9: res; 1.2k
R10: res; 1.2k
R11: res; 10k
R12: res; 1k
R13: res; 100k
R14: res; 10k
R15: res; 1k
U1: NE555
U2: NE555
V1: voltage; 5
V2: voltage; PULSE(0 3.3 1 0 0 300ms 500ms 4)
V3: voltage; PULSE(0 3.3 0.5 0 0 5.5s 8s 1)
V4: voltage; 12
Named nets: 0, WDI, RESET, WDP, WDIS, WTRIG, WDE, PWR-CTRL
.tran 8s
Tcharge = 0.693 x (R1+R2) x C2 (Watchdog timeout)
 
Tcharge = 0.693 x 60.7 x 22 = 925ms
 
 
 
Tdischarge = 0.693 x R2 x C2
 
Tdischarge = 0.693 x 4.7 x 22 = 72ms
Keep Tperiod < 0.9 to avoid RESET
Tout(high) = 1.1 x R4 x C4
 
Tout(high) = 1.1 x 10 x 10 = 110ms
High to enable watchdog
Input stage of power control circuit
