emwhbr/caramon/ltspice/watchdog_timer/wdt_enable.asc

D2: diode; 1N4148
D3: diode; 1N4148
Q1: npn
Q2: npn
Q4: npn
R1: res; 56k
R2: res; 1.2k
R6: res; 1.2k
R9: res; 1.2k
R11: res; 10k
R12: res; 1k
R13: res; 100k
V1: voltage; 5
V2: voltage; PWL(0 5 1 0 2 5 6 5 6.1 0)
V3: voltage; PULSE(0 5 3 0 0 5 8 1)
V4: voltage; 12
V5: voltage; PULSE(0 5 0 0 0 3 5 1)
Named nets: 0, OUT, CTRL_1, PWR-CTRL, CTRL_2
.tran 8s
Input stage of power control circuit
