emwhbr/caramon/ltspice/watchdog_timer/wdt_output.asc

C1: cap; 100n
D1: diode; 1N4148
D2: diode; 1N4148
Q1: npn
R1: res; 1.2k
R2: res; 10k
R3: res; 1.2k
V1: voltage; PWL(0 0 4000u 0 4150u 2 4200u 0)
V2: voltage; PWL(0 0 4000u 0 4200u 5)
Named nets: 0, CTRL, 555-OUT, IN
.tran 10m
