emwhbr/caramon/ltspice/ssr_5v_pwr_ctrl/ssr_5v_pwr_ctrl.asc

C1: cap; 10n
C2: cap; 100µF
C3: cap; 10n
C4: cap; 100µF
C5: cap; 10n
Q1: npn
Q2: npn
R1: res; 218k
R2: res; 55.8k
R3: res; 250
R4: res; 10k
R5: res; 10k
R6: res; 1k
R7: res; 1k
U1: NE555
U2: NE555
V1: voltage; 12
V2: voltage; PULSE(0 3.3 1 0 0 0.1 1 1)
Named nets: 0, SSR-NC, SSR-CTRL, DELAY-PULSE, CTRL-PULSE
.tran 35s
