emwhbr/caramon/kicad/cmon_hw_iface/cmon_hw_iface_1.sch

## KiCad design kicad/cmon_hw_iface/cmon_hw_iface_1.sch (2017-01-28)

Schematic: cmon_hw_iface_1.sch

Parts:
C1, C2, C3, C4, C5: 100nF
D1, D2, D3, D4, D5: LED
J1: DB9-FEMALE
K1: SSR-RAD; Part SX12S01X
Q1: BC548; TO92
R1, R3, R5, R9: 100k
R2, R4, R8: 119
R6, R11: 1k
R7: 10k
R10: 220
SW1: INHIBIT
U1: 74AC04
U2: MAX3232

Notes on the sheet:
To PC COM-port Straight through cable
Raspberry Pi P1 GPIO (3.3V)
ALIVE
SYSFAIL
INHIBIT
RADIATOR CTRL
TX - RS232
RX - RS232
AC 230V, to radiator NO
