emwhbr/caramon/kicad/cmon_hw_iface/cmon_hw_iface_2.sch

## KiCad design kicad/cmon_hw_iface/cmon_hw_iface_2.sch (2017-01-28)

Schematic: cmon_hw_iface_2.sch

Parts:
C6, C8, C10: 10n
C7, C9: 100u
C11: 100n
K2: SSR-5V-PWR; Part SX12S01X
Q2, Q3: BC548; TO92
R12, R17: 1k
R13: 100k
R14, R15: 10k
R16: 218k
R18: 250
R19: 55.8k
U3, U4: LM555N

Notes on the sheet:
AC 230V, to 5V PWR NC
From output stage of watchdog circuit
555 Timer IC T = 1.1 x R x C
Delay pulse (U3-Q) T = 1.1 x 218k x 100u = 23.98s
Control pulse (U4-Q) T = 1.1 x 55.8k x 100u = 6.14s
R12-250 = 4 x 1k in parallel To avoid 1/4W limit on R12
