emwhbr/caramon/kicad/cmon_hw_iface/cmon_hw_iface_3.sch

## KiCad design kicad/cmon_hw_iface/cmon_hw_iface_3.sch (2017-01-28)

Schematic: cmon_hw_iface_3.sch

Parts:
IC1: HDC1008
IC2: DS3231; SOIC-16_7.5x10.3mm_Pitch1.27mm
R20: 4.7k
U5, U6: DS18B20

Notes on the sheet:
1-WIRE
Raspberry Pi P1 GPIO (3.3V)
ADR0=ADR1=0 ADDRESS 0x40
TEMP/HUM SENSOR
RTC
I2C
TEMP SENSORS
ADDRESS 0x68
