emwhbr/caramon/kicad/cmon_hw_iface/cmon_hw_iface_4.sch

## KiCad design kicad/cmon_hw_iface/cmon_hw_iface_4.sch (2017-01-28)

Schematic: cmon_hw_iface_4.sch

Parts:
C12, C15, C16: 100n
C13, C17: 10n
C14: 22u
C18: 10u
D6, D7, D8: 1N4148
Q4, Q5, Q6, Q7: BC548; TO92
R21, R22, R26, R31, R34: 1.2k
R23: 56k
R24: 4.7k
R25: 560
R27, R32: 100k
R28, R29, R30, R33: 10k
U7, U8: LM555N

Notes on the sheet:
WDI
Raspberry Pi P1 GPIO (3.3V)
WDE
To input stage of 5V power control circuit
High to enable watchdog
Tout (high) = 1.1 x R30 x C18 Tout (high) = 1.1 x 10 x 10 = 110ms
Keep Tperiod < 0.9s to avoid watchdog timeout
Tcharge = 0.693 x (R23 + R24) x C14 (Watchdog timeout) Tcharge = 0.693 x (56 + 4.7) x 22 = 925ms Tdischarge = 0.693 x R24 x C14 Tdischarge = 0.693 x 4.7 x 22 = 72ms
