emwhbr/caramon/cmon/src/gpio.cpp

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
#include <fcntl.h>
#include <unistd.h>
#include <sys/mman.h>

#include "gpio.h"

// Implementation notes:
// 1. Datasheet "BCM2835 ARM Peripherals" (Broadcom, 2012)
//    Section 1.2 (Memory map) and 6.1 (GPIO).
//
// 2. Raspberry Pi low-level peripherals
//    http://elinux.org/RPi_Low-level_peripherals
// 
// 3. Wiring Pi GPIO library
//    http://wiringpi.com
//
// 4. Check /proc/iomem
//

/////////////////////////////////////////////////////////////////////////////
//               Definitions of macros
/////////////////////////////////////////////////////////////////////////////
#define BCM2835_PERI_BASE  0x20000000  // RPi1
#define BCM2836_PERI_BASE  0x3f000000  // RPi2
#define PERI_BASE BCM2836_PERI_BASE
#define GPIO_BASE          (PERI_BASE + 0x200000) // GPIO registers

// GPIO registers, 32-bit offset from GPIO_BASE
#define GPFSEL0_OFFSET32   0
#define GPFSEL1_OFFSET32   1
#define GPFSEL2_OFFSET32   2
#define GPFSEL3_OFFSET32   3
#define GPFSEL4_OFFSET32   4
#define GPFSEL5_OFFSET32   5
#define GPSET0_OFFSET32    7
#define GPSET1_OFFSET32    8
#define GPCLR0_OFFSET32   10
#define GPCLR1_OFFSET32   11
#define GPLEV0_OFFSET32   13
#define GPLEV1_OFFSET32   14

#define PAGE_SIZE  (4*1024)  // Kernel page size

#define CHECK_PIN_ALLOWED(pin)   \
  if (pin > GPIO_MAX_PIN) {      \
    return GPIO_PIN_NOT_ALLOWED; \
  }

/////////////////////////////////////////////////////////////////////////////
//               Module global variables
/////////////////////////////////////////////////////////////////////////////
// Memory mapped I/O access
static void              *m_gpio_map = NULL;
static volatile uint32_t *m_gpio = NULL;

/////////////////////////////////////////////////////////////////////////////
//               Private member functions
/////////////////////////////////////////////////////////////////////////////

/////////////////////////////////////////////////////////////////////////////

/////////////////////////////////////////////////////////////////////////////
//               Public member functions
/////////////////////////////////////////////////////////////////////////////

/////////////////////////////////////////////////////////////////////////////

long gpio_initialize(void)
{
  int fd_mem;

  // Open physical memory file abstraction
  fd_mem = open("/dev/mem", O_RDWR|O_SYNC);
  if (fd_mem == -1) {
    return GPIO_FILE_OPERATION_FAILED;
  }

  // Memory map GPIO registers section of peripherals
  m_gpio_map = mmap(NULL,                  // Any adddress in our space will do
		    PAGE_SIZE,             // Map length
		    PROT_READ | PROT_WRITE,// Enable reading & writting to mapped memory
		    MAP_SHARED,            // Shared with other processes
		    fd_mem,                // File to map
		    GPIO_BASE);            // Offset to GPIO peripheral registers

  if ( m_gpio_map == MAP_FAILED ) {
    close(fd_mem);
    return GPIO_MEMORY_MAP_FAILED;
  }

  // No need to keep descriptor open
  if ( close(fd_mem) == -1 ) {
    munmap(m_gpio_map, PAGE_SIZE);
    return GPIO_FILE_OPERATION_FAILED;
  }

  m_gpio = (volatile uint32_t *) m_gpio_map;

  return GPIO_SUCCESS;
}

/////////////////////////////////////////////////////////////////////////////

long gpio_finalize(void)
{
  if ( munmap(m_gpio_map, PAGE_SIZE) == -1 ) {
    return GPIO_MEMORY_MAP_FAILED;
  }

  return GPIO_SUCCESS;
}

/////////////////////////////////////////////////////////////////////////////

long gpio_set_function(uint8_t pin,
		       GPIO_FUNCTION func)
{
  CHECK_PIN_ALLOWED(pin);

  long offset32;
  switch (pin / 10) {
  case 0:
    offset32 = GPFSEL0_OFFSET32;  // pin 0..9
    break;
  case 1:
    offset32 = GPFSEL1_OFFSET32;  // pin 10..19
    break;
  case 2:
    offset32 = GPFSEL2_OFFSET32;  // pin 20..29
    break;
  case 3:
    offset32 = GPFSEL3_OFFSET32;  // pin 30..39
    break;
  default:
    return GPIO_PIN_NOT_ALLOWED;
  }

  // Function is 3 bits for each of the 10 pins
  
  uint32_t gpfsel_reg = *(m_gpio + offset32);

  // Always set to INPUT first
  if (func != GPIO_FUNC_INP) {
    gpfsel_reg &= ~( 0x7 << ((pin%10) * 3) ); // Clear function bits for pin
    *(m_gpio + offset32) = gpfsel_reg;
  }
  
  gpfsel_reg = *(m_gpio + offset32);

  gpfsel_reg &= ~( 0x7 << ((pin%10) * 3) ); // Clear function bits for pin
  gpfsel_reg |= ( func << ((pin%10) * 3) ); // Set function bits for pin

  *(m_gpio + offset32) = gpfsel_reg;

  return GPIO_SUCCESS;
}

/////////////////////////////////////////////////////////////////////////////

long gpio_get_function(uint8_t pin,
		       GPIO_FUNCTION &func)
{
  CHECK_PIN_ALLOWED(pin);

  long offset32;
  switch (pin / 10) {
  case 0:
    offset32 = GPFSEL0_OFFSET32;  // pin 0..9
    break;
  case 1:
    offset32 = GPFSEL1_OFFSET32;  // pin 10..19
    break;
  case 2:
    offset32 = GPFSEL2_OFFSET32;  // pin 20..29
    break;
  case 3:
    offset32 = GPFSEL3_OFFSET32;  // pin 30..39
    break;
  default:
    return GPIO_PIN_NOT_ALLOWED;
  }

  // Function is 3 bits for each of the 10 pins
  func = (GPIO_FUNCTION) ( (*(m_gpio + offset32) >> ((pin%10) * 3)) & 0x7 );

  return GPIO_SUCCESS;
}

/////////////////////////////////////////////////////////////////////////////

long gpio_write(uint8_t pin,
		uint8_t value)
{
  CHECK_PIN_ALLOWED(pin);

  // Note!
  // Writing 0 to a bit has no effect on corresponding pin.
  // This is valid for both set and clear.
  if (value) {
    *(m_gpio + GPSET0_OFFSET32) = 1 << pin;
  }
  else {
    *(m_gpio + GPCLR0_OFFSET32) = 1 << pin;
  }

  return GPIO_SUCCESS;
}

/////////////////////////////////////////////////////////////////////////////

long gpio_read(uint8_t pin,
	       uint8_t &value)
{
  CHECK_PIN_ALLOWED(pin);

  // Read actual value of pin
  if ( *(m_gpio + GPLEV0_OFFSET32) & (1 << pin)  ) {
    value = 1;
  }
  else {
    value = 0;
  }

  return GPIO_SUCCESS;
}
