emwhbr/caramon/cmon/src/cmon_controller_data_queue.h

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
#ifndef __CMON_CONTROLLER_DATA_QUEUE_H__
#define __CMON_CONTROLLER_DATA_QUEUE_H__

#include <string>

#include "cmon_controller_data.h"
#include "msg_fifo_queue.h"
#include "basic_memory_pool.h"

using namespace std;

/////////////////////////////////////////////////////////////////////////////
//               Definitions of macros
/////////////////////////////////////////////////////////////////////////////
// Return codes
#define CMON_CONTROLLER_DATA_QUEUE_SUCCESS       0
#define CMON_CONTROLLER_DATA_QUEUE_FAILURE      -1
#define CMON_CONTROLLER_DATA_QUEUE_WOULD_BLOCK  -2
#define CMON_CONTROLLER_DATA_QUEUE_TIMEDOUT     -3
#define CMON_CONTROLLER_DATA_QUEUE_MAX_LIMIT    -4

/////////////////////////////////////////////////////////////////////////////
//               Class support types
/////////////////////////////////////////////////////////////////////////////

/////////////////////////////////////////////////////////////////////////////
//               Definition of classes
/////////////////////////////////////////////////////////////////////////////

class cmon_controller_data_queue {

 public:
  cmon_controller_data_queue(void);
  cmon_controller_data_queue(unsigned nr_pool_elements);
  ~cmon_controller_data_queue(void);

  ///// Memory pool operations

  long allocate_pool(cmon_controller_data *&ptr);   // Call before send to queue

  long deallocate_pool(cmon_controller_data *&ptr); // Call after receive from queue

  long size_pool(unsigned &value);

  ///// Queue operations

  long send(const cmon_controller_data *ptr);

  long recv(cmon_controller_data *&ptr,
	    bool wait);

  long recv(cmon_controller_data *&ptr,
	    double timeout_in_sec);

  long size_queue(unsigned &value);

  long clear_queue(void);

 private:
  // The actual queue
  msg_fifo_queue<cmon_controller_data *> m_item_queue;

  // Item pool
  basic_memory_pool<cmon_controller_data> *m_item_pool;
};

#endif // __CMON_CONTROLLER_DATA_QUEUE_H__
