emwhbr/caramon/cmon/src/cmon_log_disk.cpp

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
#include <sstream>
#include <iomanip>

#include "cmon_log_disk.h"
#include "cmon_io.h"

/////////////////////////////////////////////////////////////////////////////
//               Definitions of macros
/////////////////////////////////////////////////////////////////////////////

/////////////////////////////////////////////////////////////////////////////
//               Public member functions
/////////////////////////////////////////////////////////////////////////////

////////////////////////////////////////////////////////////////

cmon_log_disk::
cmon_log_disk(string name,
	      bool verbose,
	      string climate_data_file_name) : cmon_log(name,
							verbose)
{
  if (m_verbose) {
    cmon_io_put("%s : cmon_log_disk::cmon_log_disk\n", m_name.c_str());
  }
  m_climate_data_file = new cmon_file(climate_data_file_name);
}

////////////////////////////////////////////////////////////////

cmon_log_disk::~cmon_log_disk(void)
{
  if (m_verbose) {
    cmon_io_put("%s : cmon_log_disk::~cmon_log_disk\n", m_name.c_str());
  }
  delete m_climate_data_file;
}

////////////////////////////////////////////////////////////////

void cmon_log_disk::initialize(void)
{
  m_climate_data_file->open_file(CMON_FILE_WRITEONLY);
}

////////////////////////////////////////////////////////////////

void cmon_log_disk::finalize(void)
{
  m_climate_data_file->close_file();
}

////////////////////////////////////////////////////////////////

void cmon_log_disk::log_data(const CMON_CLIMATE_DATA *climate_data,
			     const CMON_CONTROLLER_DATA *controller_data)
{
  // NOTE!
  // Creates an entry in climate data file according to:
  // <date&time>;<internal mean temp>;<internal mean hum>;<external 1 mean temp>;<external 2 mean temp>;<pid duty>;<pid set value>

  // Decorate message with date and time (from climate data)
  ostringstream ossMsg;
  ossMsg.str("");
  ossMsg << this->get_iso8601_date_time_str(&climate_data->time.tstruct) << ";";

  // Internal climate
  if (climate_data->internal_temperature.valid) {
    ossMsg << fixed << setw(8) << setprecision(3)
	   << climate_data->internal_temperature.mean << ";";
  }
  else {
    ossMsg << "not valid" << ";";
  }
  if (climate_data->internal_humidity.valid) {    
    ossMsg << fixed << setw(8) << setprecision(3)
	   << climate_data->internal_humidity.mean << ";";
  }
  else {
    ossMsg << "not valid" << ";";
  }

  // External climate 1
  if (climate_data->external_temperature_1.valid) {
    ossMsg << fixed << setw(8) << setprecision(3)
	   << climate_data->external_temperature_1.mean << ";";
  }
  else {
    ossMsg << "not valid" << ";";
  }

  // External climate 2
  if (climate_data->external_temperature_2.valid) {
    ossMsg << fixed << setw(8) << setprecision(3)
	   << climate_data->external_temperature_2.mean << ";";
  }
  else {
    ossMsg << "not valid" << ";";
  }

  // Controller PID - duty
  if (controller_data->duty.valid) {
    ossMsg << fixed << setw(8) << setprecision(2)
	   << controller_data->duty.mean << ";";
  }
  else {
    ossMsg << "not valid" << ";";
  }

  // Controller PID - set value
  if (controller_data->set_value.valid) {
    ossMsg << fixed << setw(8) << setprecision(3)
	   << controller_data->set_value.mean << ";";
  }
  else {
    ossMsg << "not valid" << ";";
  }

  ossMsg << "\n";

  // Log to file
  m_climate_data_file->write_file((const uint8_t *)ossMsg.str().c_str(),
				  (unsigned)ossMsg.str().length());
}

/////////////////////////////////////////////////////////////////////////////
//               Private member functions
/////////////////////////////////////////////////////////////////////////////

////////////////////////////////////////////////////////////////
