emwhbr/caramon/cmon/src/cmon_power_switch_ssr.cpp

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
#include "cmon_power_switch_ssr.h"
#include "cmon_exception.h"
#include "cmon_io.h"

/////////////////////////////////////////////////////////////////////////////
//               Definitions of macros
/////////////////////////////////////////////////////////////////////////////

/////////////////////////////////////////////////////////////////////////////
//               Public member functions
/////////////////////////////////////////////////////////////////////////////

////////////////////////////////////////////////////////////////

cmon_power_switch_ssr::
cmon_power_switch_ssr(string name,
		     uint8_t pin,
		     bool verbose) : cmon_power_switch(name, verbose) 
{
  m_ssr_pin = new io_pin_out(name, pin, false); // Active high (false)
}

////////////////////////////////////////////////////////////////

cmon_power_switch_ssr::~cmon_power_switch_ssr(void)
{
  delete m_ssr_pin;
}

////////////////////////////////////////////////////////////////

void cmon_power_switch_ssr::initialize(void)
{
  long rc;

  rc = m_ssr_pin->initialize();
  if (rc != IO_PIN_SUCCESS) {
    THROW_EXP(CMON_INTERNAL_ERROR, CMON_GPIO_ERROR,
	      "Initialize %s pin(%u) failed",
	      m_ssr_pin->get_name().c_str(), m_ssr_pin->get_pin());
  }
}

////////////////////////////////////////////////////////////////

void cmon_power_switch_ssr::finalize(void)
{
  long rc;

  rc = m_ssr_pin->finalize(true);  // Restore pin (true)
  if (rc != IO_PIN_SUCCESS) {
    THROW_EXP(CMON_INTERNAL_ERROR, CMON_GPIO_ERROR,
	      "Finalize %s pin(%u) failed",
	      m_ssr_pin->get_name().c_str(), m_ssr_pin->get_pin());
  }
}

////////////////////////////////////////////////////////////////

void cmon_power_switch_ssr::switch_on(void)
{
  long rc;

  rc = m_ssr_pin->activate();
  if (rc != IO_PIN_SUCCESS) {
    THROW_EXP(CMON_INTERNAL_ERROR, CMON_GPIO_ERROR,
	      "Activate %s pin(%u) failed",
	      m_ssr_pin->get_name().c_str(), m_ssr_pin->get_pin());
  }
}

////////////////////////////////////////////////////////////////

void cmon_power_switch_ssr::switch_off(void)
{
  long rc;

  rc = m_ssr_pin->deactivate();
  if (rc != IO_PIN_SUCCESS) {
    THROW_EXP(CMON_INTERNAL_ERROR, CMON_GPIO_ERROR,
	      "Deactivate %s pin(%u) failed",
	      m_ssr_pin->get_name().c_str(), m_ssr_pin->get_pin());
  }
}

/////////////////////////////////////////////////////////////////////////////
//               Private member functions
/////////////////////////////////////////////////////////////////////////////

////////////////////////////////////////////////////////////////
