emwhbr/caramon/cmon/src/io_pin_out.cpp

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
#include "io_pin_out.h"

/////////////////////////////////////////////////////////////////////////////
//               Definitions of macros
/////////////////////////////////////////////////////////////////////////////

/////////////////////////////////////////////////////////////////////////////
//               Public member functions
/////////////////////////////////////////////////////////////////////////////

////////////////////////////////////////////////////////////////

io_pin_out::io_pin_out(string name,
		       uint8_t pin,
		       bool active_low) : io_pin(name,
						 pin,
						 false, // Dir = OUT (false)
						 active_low)
{
  m_activated = false;
}

////////////////////////////////////////////////////////////////

io_pin_out::~io_pin_out()
{
}

////////////////////////////////////////////////////////////////

long io_pin_out::activate(void)
{
  long rc;
  uint8_t value;

  if (m_active_low) {
    value = 0;
  }
  else {
    value = 1;
  }

  rc = gpio_write(m_pin, value);
  if (rc != GPIO_SUCCESS) {
    return IO_PIN_FAILURE;
  }

  m_activated = true;

  return IO_PIN_SUCCESS;
}

////////////////////////////////////////////////////////////////

long io_pin_out::deactivate(void)
{
  long rc;
  uint8_t value;

  if (m_active_low) {
    value = 1;
  }
  else {
    value = 0;
  }

  rc = gpio_write(m_pin, value);
  if (rc != GPIO_SUCCESS) {
    return IO_PIN_FAILURE;
  }

  m_activated = false;

  return IO_PIN_SUCCESS;
}

////////////////////////////////////////////////////////////////

bool io_pin_out::activated(void)
{
  return m_activated;
}

/////////////////////////////////////////////////////////////////////////////
//               Private member functions
/////////////////////////////////////////////////////////////////////////////

////////////////////////////////////////////////////////////////
