emwhbr/caramon/pid_heater/src/timer.h

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
#ifndef __TIMER_H__
#define __TIMER_H__

#include <time.h>

/////////////////////////////////////////////////////////////////////////////
//               Definition of macros
/////////////////////////////////////////////////////////////////////////////
// Return codes
#define TIMER_SUCCESS   0
#define TIMER_FAILURE  -1

/////////////////////////////////////////////////////////////////////////////
//               Class support types
/////////////////////////////////////////////////////////////////////////////

/////////////////////////////////////////////////////////////////////////////
//               Definition of classes
/////////////////////////////////////////////////////////////////////////////

class timer {

 public:
  timer(void);
  ~timer(void);
  
  long reset(void);
  long pause(void);
  long resume(void);

  double get_elapsed_time(void); // Total time (paused + running)
  double get_running_time(void); // Only time when NOT paused

  bool is_running(void);

 private:
  bool	  m_timer_running;
  double  m_running_time;

  struct timespec m_start_time;
  struct timespec m_last_start_time;

  double get_time_diff(timespec start, timespec end);
};

#endif // __TIMER_H__
