emwhbr/caramon/cmon/src/cmon_thread_utility.cpp

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
#include "cmon_thread_utility.h"
#include "cmon.h"
#include "cmon_exception.h"
#include "timer.h"
#include "delay.h"

/////////////////////////////////////////////////////////////////////////////
//               Definitions of macros
/////////////////////////////////////////////////////////////////////////////

/////////////////////////////////////////////////////////////////////////////
//               Module global variables
/////////////////////////////////////////////////////////////////////////////

/////////////////////////////////////////////////////////////////////////////
//               Public member functions
/////////////////////////////////////////////////////////////////////////////

////////////////////////////////////////////////////////////////

void cmon_thread_initialize(thread *ct,
			    double ct_start_timeout,
			    double ct_execute_timeout)
{
  // Step 1: Start thread
  if ( ct->start(NULL) != THREAD_SUCCESS ) {
    THROW_EXP(CMON_INTERNAL_ERROR, CMON_THREAD_OPERATION_FAILED,
	      "Error start thread %s",
	      ct->get_name().c_str());
  }

  // Step 2: Wait for thread to complete setup
  timer thread_timer;
  bool thread_timeout = true;
  if ( thread_timer.reset() != TIMER_SUCCESS ) {
    THROW_EXP(CMON_INTERNAL_ERROR, CMON_TIME_ERROR,
	      "Error resetting timeout timer(start) for thread %s",
	      ct->get_name().c_str());
  }
  while ( thread_timer.get_elapsed_time() < ct_start_timeout ) {
    if ( ct->get_state() == THREAD_STATE_SETUP_DONE ) {
      thread_timeout = false;
      break;
    }
    if ( delay(0.001) != DELAY_SUCCESS ) {
      THROW_EXP(CMON_INTERNAL_ERROR, CMON_TIME_ERROR,
		"Delay operation failed(start), waiting for thread %s",
		ct->get_name().c_str());
    }
  }
  if ( thread_timeout ) {
    THROW_EXP(CMON_INTERNAL_ERROR, CMON_TIMEOUT_OCCURRED,
	      "Timeout waiting for start thread %s",
	      ct->get_name().c_str());
  }
  if ( ct->get_status() != THREAD_STATUS_OK ) {
    THROW_EXP(CMON_INTERNAL_ERROR, CMON_THREAD_STATUS_NOT_OK,
	      "Thread %s status not OK, status:0x%x, state:%u",
	      ct->get_name().c_str(),
	      ct->get_status(),
	      ct->get_state());
  }

  // Step 3: Release thread
  if ( ct->release() != THREAD_SUCCESS ) {
    THROW_EXP(CMON_INTERNAL_ERROR, CMON_THREAD_OPERATION_FAILED,
	      "Error release thread %s",
	      ct->get_name().c_str());
  }

  // Step 4: Wait for thread to start executing
  //         or become stopped (for fast threads)
  thread_timeout = true;
  if ( thread_timer.reset() != TIMER_SUCCESS ) {
    THROW_EXP(CMON_INTERNAL_ERROR, CMON_TIME_ERROR,
	      "Error resetting timeout timer(execute) for thread %s",
	      ct->get_name().c_str());
  }
  while ( thread_timer.get_elapsed_time() < ct_execute_timeout ) {
    if ( (ct->get_state() == THREAD_STATE_EXECUTING) ||
	 (ct->get_state() == THREAD_STATE_STOPPED) ) {
      thread_timeout = false;
      break;
    }
    if ( delay(0.001) != DELAY_SUCCESS ) {
      THROW_EXP(CMON_INTERNAL_ERROR, CMON_TIME_ERROR,
		"Delay operation failed(execute), waiting for thread %s",
		ct->get_name().c_str());
    }
  }
  if ( thread_timeout ) {
    THROW_EXP(CMON_INTERNAL_ERROR, CMON_TIMEOUT_OCCURRED,
	      "Timeout waiting for execute thread %s",
	      ct->get_name().c_str());
  }
  if ( ct->get_status() != THREAD_STATUS_OK ) {
    THROW_EXP(CMON_INTERNAL_ERROR, CMON_THREAD_STATUS_NOT_OK,
	      "Thread %s status not OK, status:0x%x, state:%u",
	      ct->get_name().c_str(),
	      ct->get_status(),
	      ct->get_state());
  }
}

////////////////////////////////////////////////////////////////

void cmon_thread_finalize(thread *ct,
			  double ct_stop_timeout)
{
  // Step 0: Check that thread was created
  if ( ct->get_thread() == 0) {
    return; // No thread exists to finalize
  }

  // Step 1: Stop thread
  if ( ct->stop() != THREAD_SUCCESS ) {    
    THROW_EXP(CMON_INTERNAL_ERROR, CMON_THREAD_OPERATION_FAILED,
	      "Error stop thread %s, status:0x%x, state:%u",
	      ct->get_name().c_str(),
	      ct->get_status(),
	      ct->get_state());
  }

  // Make sure thread isn't hanged in setup
  if ( ct->get_state() == THREAD_STATE_SETUP_DONE ) {
    if ( ct->release() != THREAD_SUCCESS ) {
      THROW_EXP(CMON_INTERNAL_ERROR, CMON_THREAD_OPERATION_FAILED,
		"Error release thread %s, status:0x%x, state:%u",
		ct->get_name().c_str(),
		ct->get_status(),
		ct->get_state());
    }
  }

  // Step 2: Complete thread
  if ( ct->complete() != THREAD_SUCCESS ) {    
    THROW_EXP(CMON_INTERNAL_ERROR, CMON_THREAD_OPERATION_FAILED,
	      "Error complete thread %s, status:0x%x, state:%u",
	      ct->get_name().c_str(),
	      ct->get_status(),
	      ct->get_state());
  }
  
  // Step 3: Wait for thread to be done
  if ( ct->wait_timed(ct_stop_timeout) != THREAD_SUCCESS ) {
    THROW_EXP(CMON_INTERNAL_ERROR, CMON_THREAD_OPERATION_FAILED,
	      "Error wait_timed thread %s, status:0x%x, state:%u",
	      ct->get_name().c_str(),
	      ct->get_status(),
	      ct->get_state());
  }
}

////////////////////////////////////////////////////////////////

void cmon_thread_check_running(thread *ct)
{
  // Check state (executing)
  if ( ct->get_state() != THREAD_STATE_EXECUTING ) {
    THROW_EXP(CMON_INTERNAL_ERROR, CMON_THREAD_STATE_NOT_OK,
	      "Thread %s not executing, status:0x%x, state:%u",
	      ct->get_name().c_str(),
	      ct->get_status(),
	      ct->get_state());
  }

  // Check status (ok)
  if ( ct->get_status() != THREAD_STATUS_OK ) {
    THROW_EXP(CMON_INTERNAL_ERROR, CMON_THREAD_STATUS_NOT_OK,
	      "Thread %s status not OK, status:0x%x, state:%u",
	      ct->get_name().c_str(),
	      ct->get_status(),
	      ct->get_state());
  }
}

////////////////////////////////////////////////////////////////

void cmon_thread_check_status(thread *ct)
{
  // Check status (ok)
  if ( ct->get_status() != THREAD_STATUS_OK ) {
    THROW_EXP(CMON_INTERNAL_ERROR, CMON_THREAD_STATUS_NOT_OK,
	      "Thread %s status not OK, status:0x%x, state:%u",
	      ct->get_name().c_str(),
	      ct->get_status(),
	      ct->get_state());
  }
}
