emwhbr/caramon/(commit log)

2016-01-08 Added WiringPi and rcswitch-pi
2016-01-23 Added PID/PWM test applications and updated documentation
    [cmon_climate.ods]
2016-01-26 Added PID control of internal temperature
2016-01-30 Changed temperature set value to 9 degC
2017-01-20 Added KiCad project cmon_hw_iface for schematics
    [cmon_hw_iface.sch, cmon_hw_iface_1.sch, cmon_hw_iface_2.sch, cmon_hw_iface_3.sch]
2017-01-23 Began hardware watcdog
    [cmon_hw_iface.sch, cmon_hw_iface_1.sch, cmon_hw_iface_2.sch, cmon_hw_iface_3.sch, cmon_hw_iface_4.sch]
2017-01-25 Updated hardware watchdog
    [cmon_hw_iface.sch, cmon_hw_iface_1.sch, cmon_hw_iface_2.sch, cmon_hw_iface_3.sch, cmon_hw_iface_4.sch]
2017-01-28 Hardware watchdog now runs on 12v
    [cmon_hw_iface.sch, cmon_hw_iface_1.sch, cmon_hw_iface_2.sch, cmon_hw_iface_3.sch, cmon_hw_iface_4.sch]
2017-02-27 Using true Ziegler-Nichols PID for new hardware
    [2017-02-25-15:12:09_cmon_climate.ods, 2017-02-26-16:11:49_cmon_climate.ods, cmon_climate.ods]
2017-03-05 Changed set temperature to 8.0degC
