emwhbr/caramon/(notices)

Notices in the files:
cmon/src/cmon_fallback.cpp:
Copyright (C) 2016 Bonden i Nol (hakanbrolin@hotmail.com)
This program is free software; you can redistribute it and/or modify
it under the terms of the GNU General Public License as published by
the Free Software Foundation; either version 2 of the License, or
(at your option) any later version.
cmon/src/cmon_io.cpp:
Copyright (C) 2015 Bonden i Nol (hakanbrolin@hotmail.com)
cmon/src/cmon_wdt.cpp:
Copyright (C) 2017 Bonden i Nol (hakanbrolin@hotmail.com)
